lhr-solar/PS-Amperes/Hardware/docs/render.png

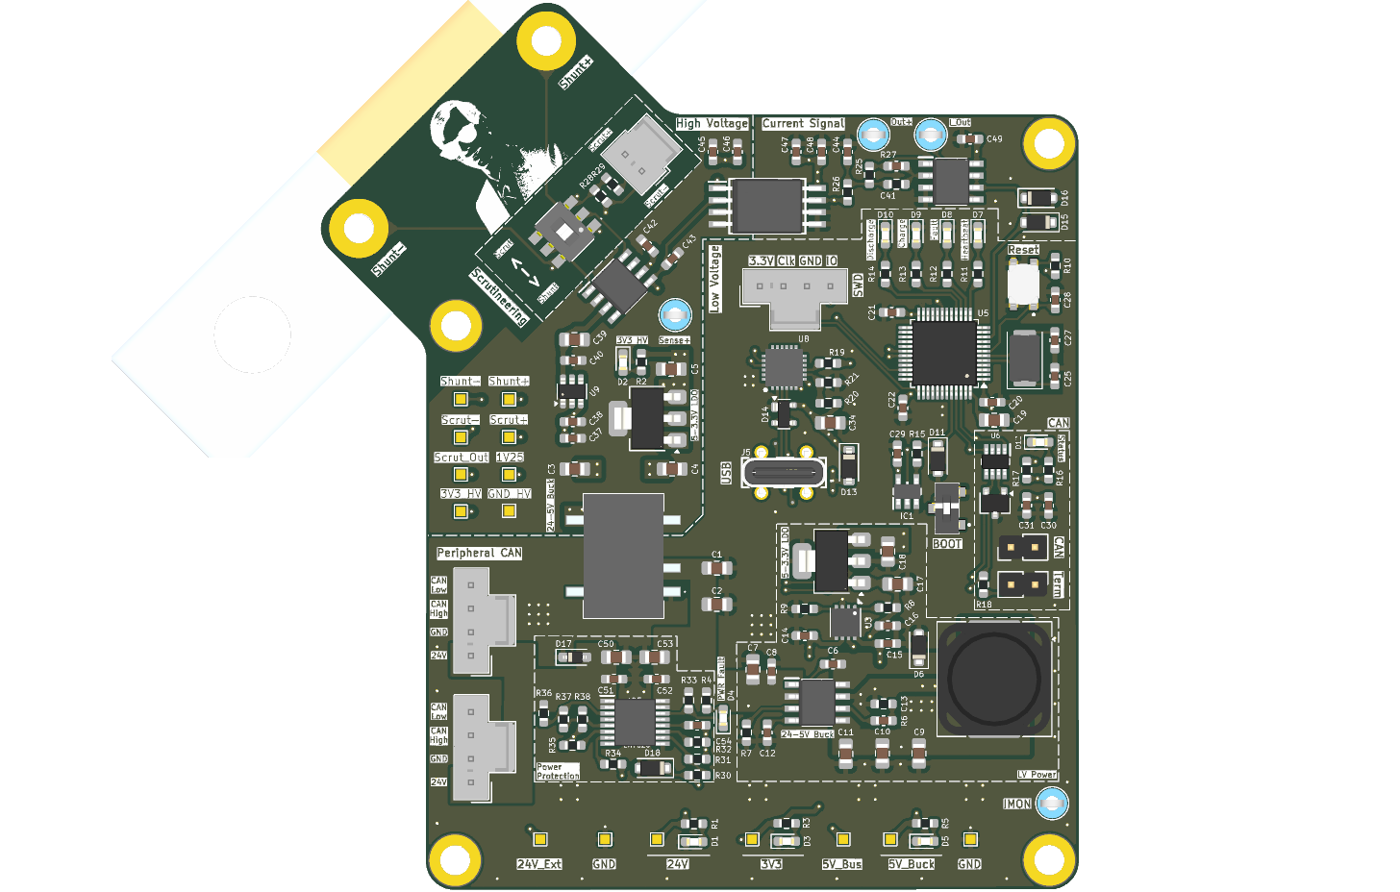
Hardware/docs/render.png
