lhr-solar/PS-Amperes/Hardware/Components/AMC1350DWVR/AMC1350DWVR.stp

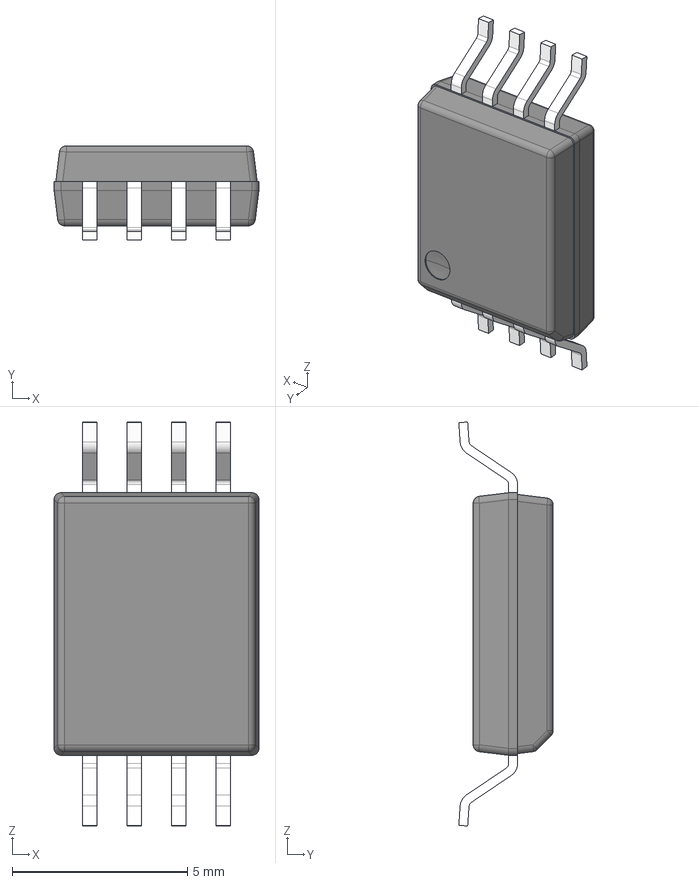
[picture p2: CAD file, 2025-11-04]
Hardware/Components/AMC1350DWVR/AMC1350DWVR.stp
5.85 x 2.70 x 11.5 mm
BODY-SOIC
LEAD-DWV0008A x 8
