lhr-solar/PS-Amperes/Hardware/Components/INA241A5IDR/INA241A5IDR.stp

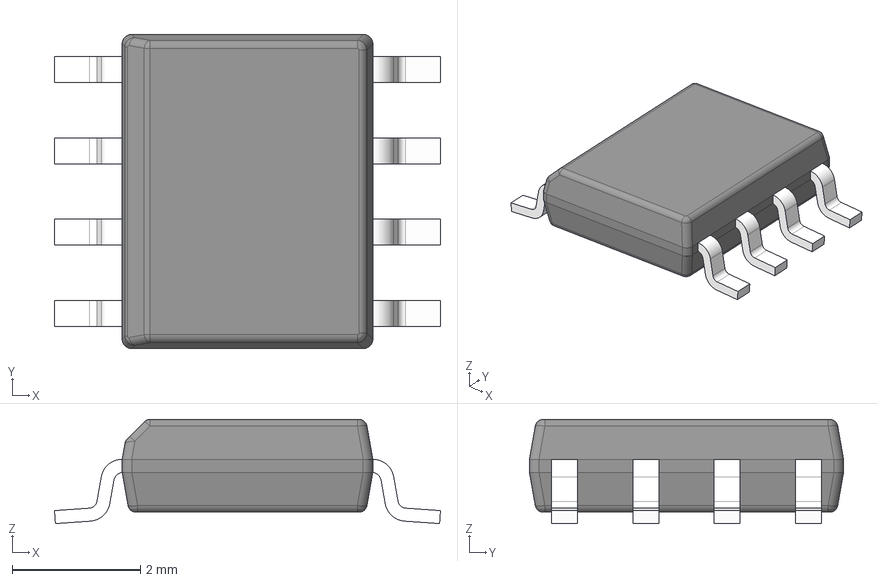
[picture p3: CAD file, 2025-11-04]
Hardware/Components/INA241A5IDR/INA241A5IDR.stp
6.02 x 4.90 x 1.63 mm
BODY-SO
LEAD-D0008A x 8
