lhr-solar/PS-Amperes/Hardware/Components/SN74AHC1G32DBVR/SN74AHC1G32DBVR.stp

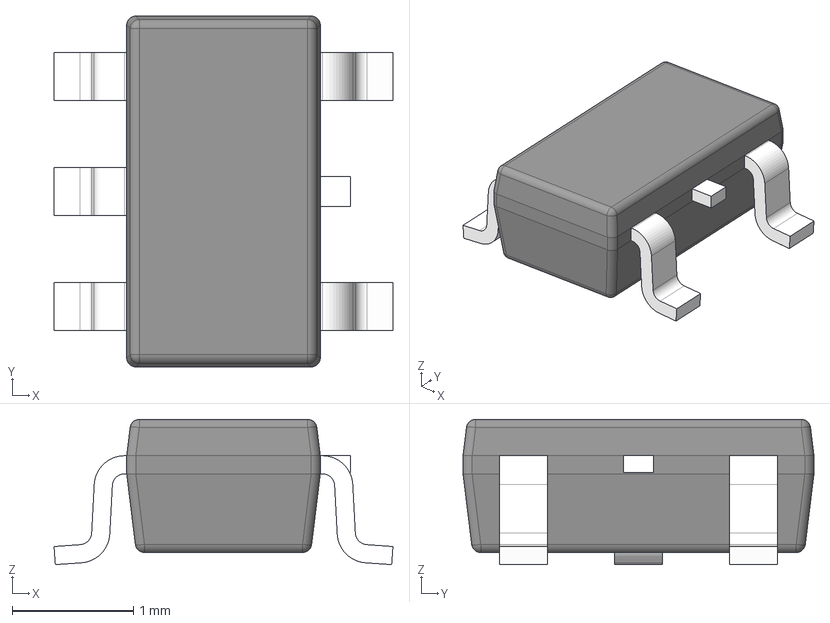
[picture p4: CAD file, 2025-11-04]
Hardware/Components/SN74AHC1G32DBVR/SN74AHC1G32DBVR.stp
2.80 x 2.90 x 1.20 mm
BODY-SOT
LEAD-SOT x 5
LEAD-DUMMY
