lhr-solar/PS-Amperes/Hardware/Components/TL3365AF180QG/TL3365AF180QG.step

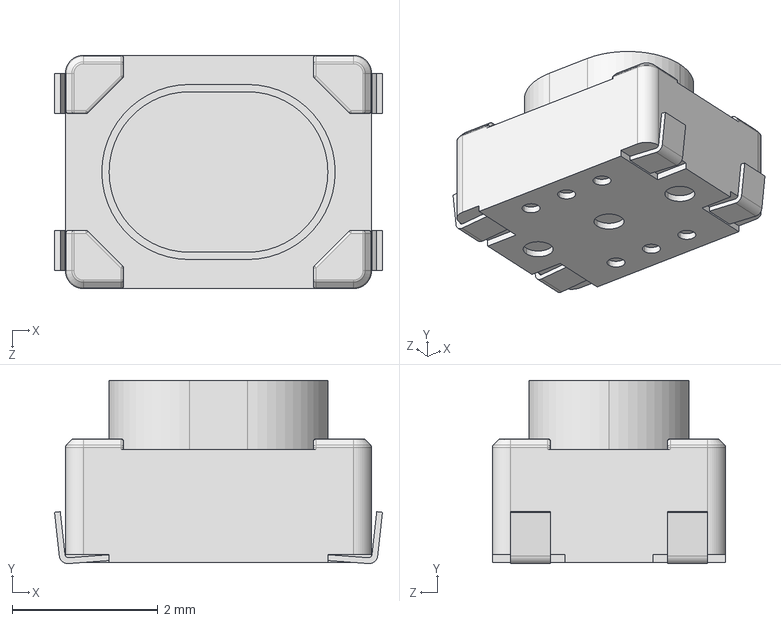
[picture p5: CAD file, 2025-11-04]
Hardware/Components/TL3365AF180QG/TL3365AF180QG.step
4.50 x 2.51 x 3.20 mm
