lhr-solar/PS-Amperes/Hardware/Components/TPS2115ADRBR/TPS2115ADRBR.step

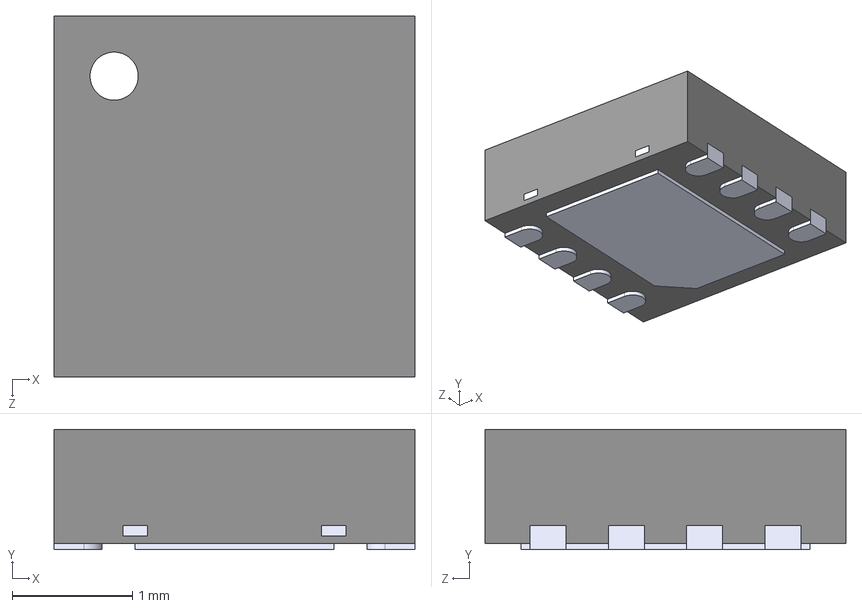
[picture p6: CAD file, 2025-11-04]
Hardware/Components/TPS2115ADRBR/TPS2115ADRBR.step
3.00 x 1.00 x 3.00 mm
