lhr-solar/PS-Amperes/Hardware/Components/USB4120-03-C/USB4120-03-C.stp

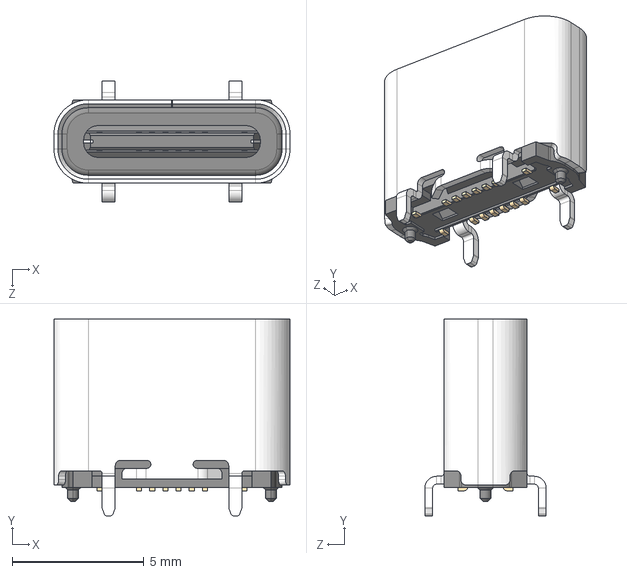
[picture p7: CAD file, 2025-11-04]
Hardware/Components/USB4120-03-C/USB4120-03-C.stp
8.94 x 7.45 x 4.60 mm
