lhr-solar/PS-Amperes/Hardware/Components/WSBS8518L2500JKM4/WSBS8518L2500JKM4.stp

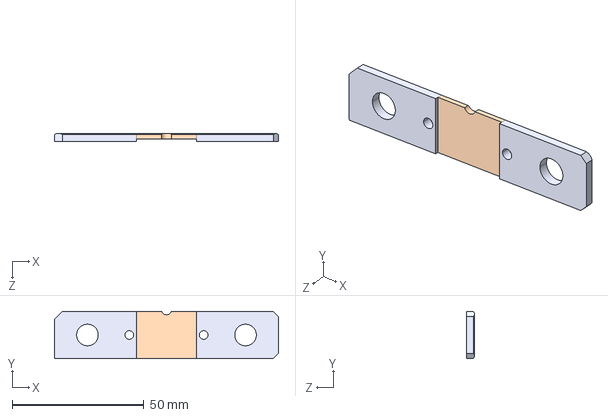
[picture p8: CAD file, 2025-11-04]
Hardware/Components/WSBS8518L2500JKM4/WSBS8518L2500JKM4.stp
85.0 x 18.0 x 3.00 mm
