lhr-solar/PS-Amperes/Hardware/Reference/amperesmax.DXF

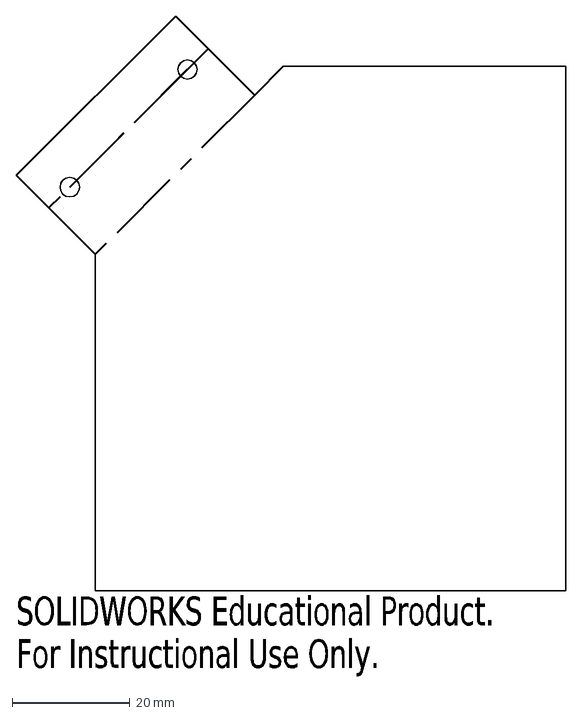
[picture p9: CAD file, 2025-11-04]
Hardware/Reference/amperesmax.DXF
SOLIDWORKS Educational Product.
For Instructional Use Only.
