lhr-solar/PS-Amperes/Hardware/docs/PS-AmperesPCB.pdf

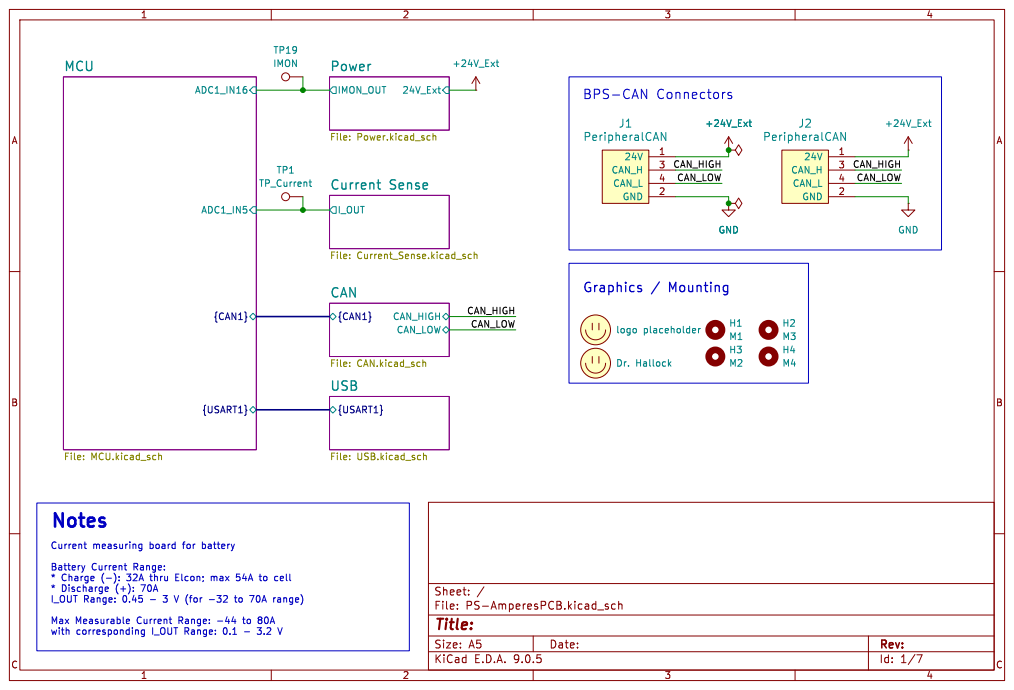
[picture p10: page 1]

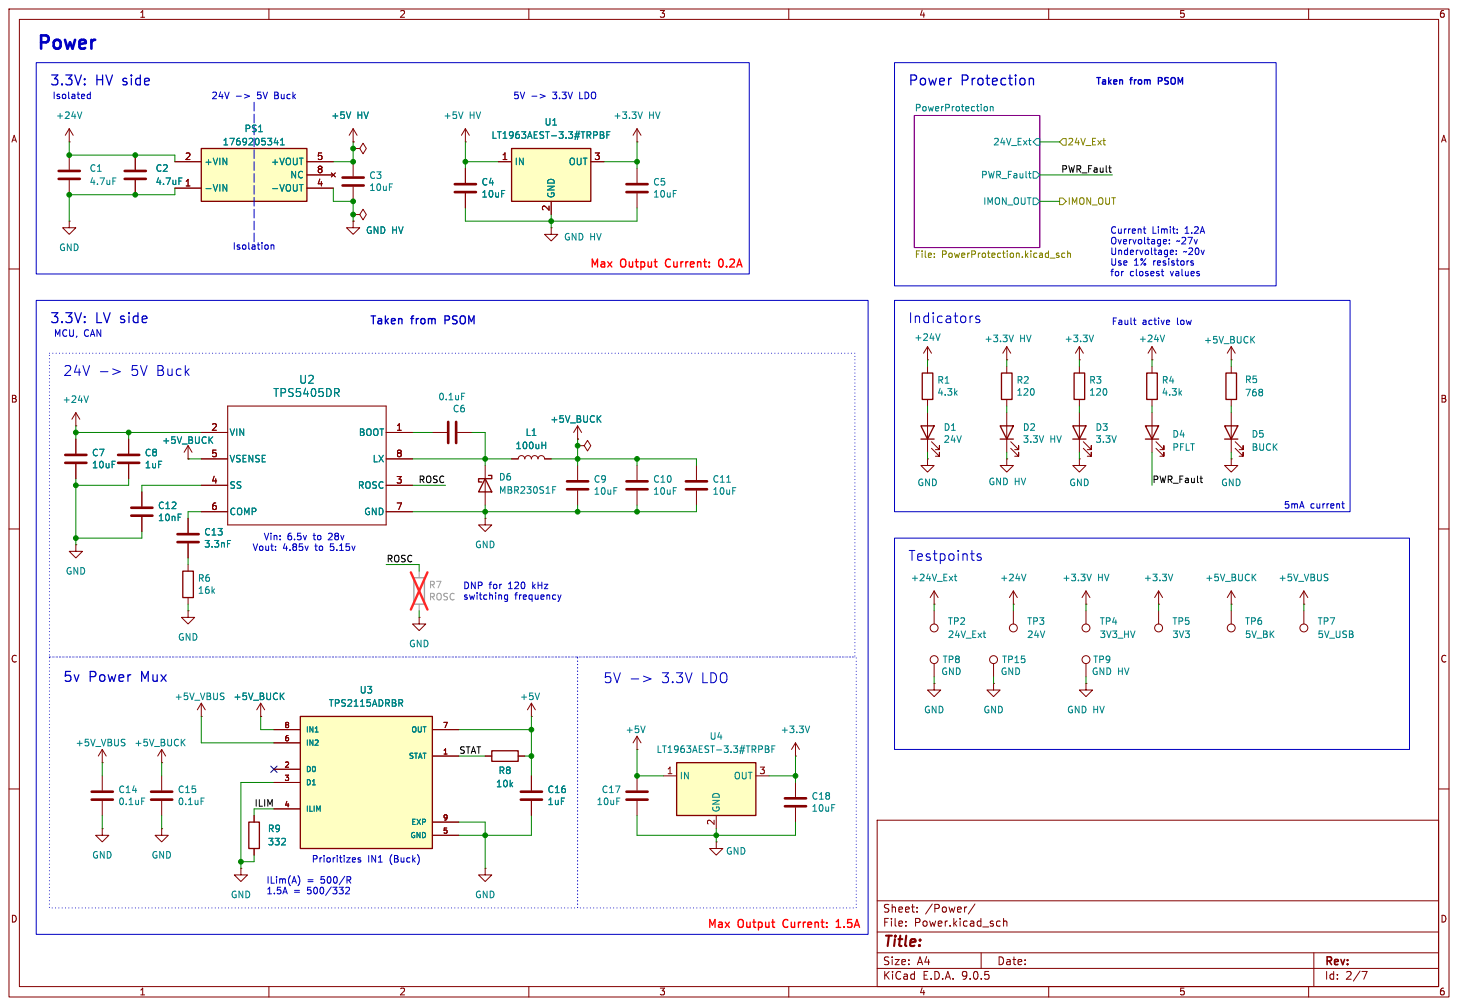
[picture p11: page 2]

Indicators Max Output Current: 0.2A

Vin: 6.5v to 28v Vout: 4.85v to 5.15v 5v Power Mux

Id: 2/7 Title: File: Power.kicad_sch Sheet: /Power/

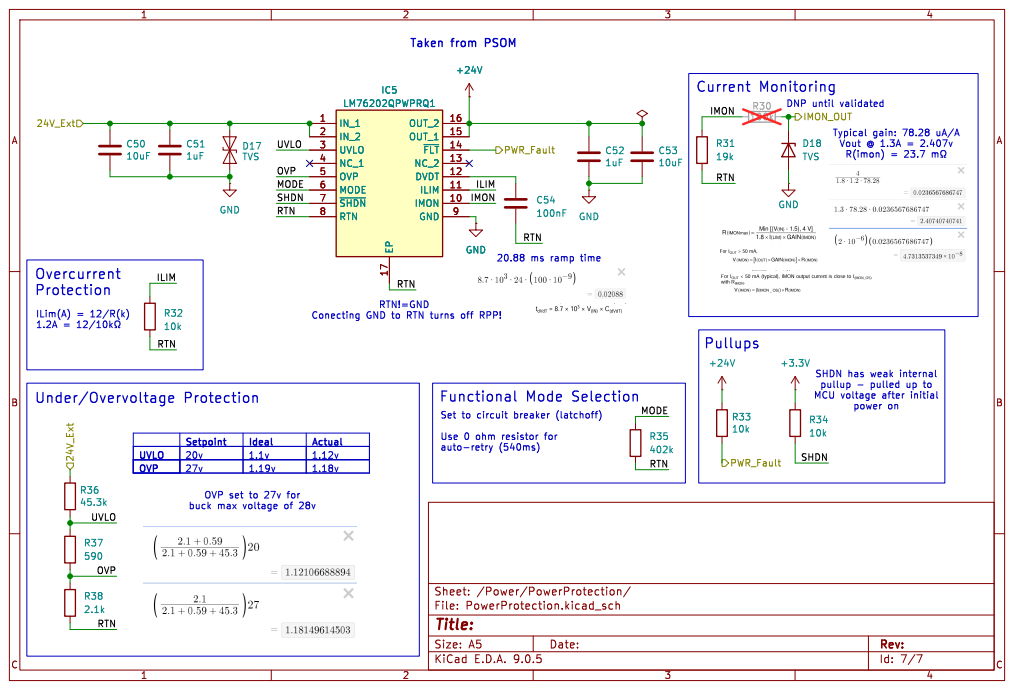
[picture p12: page 3]

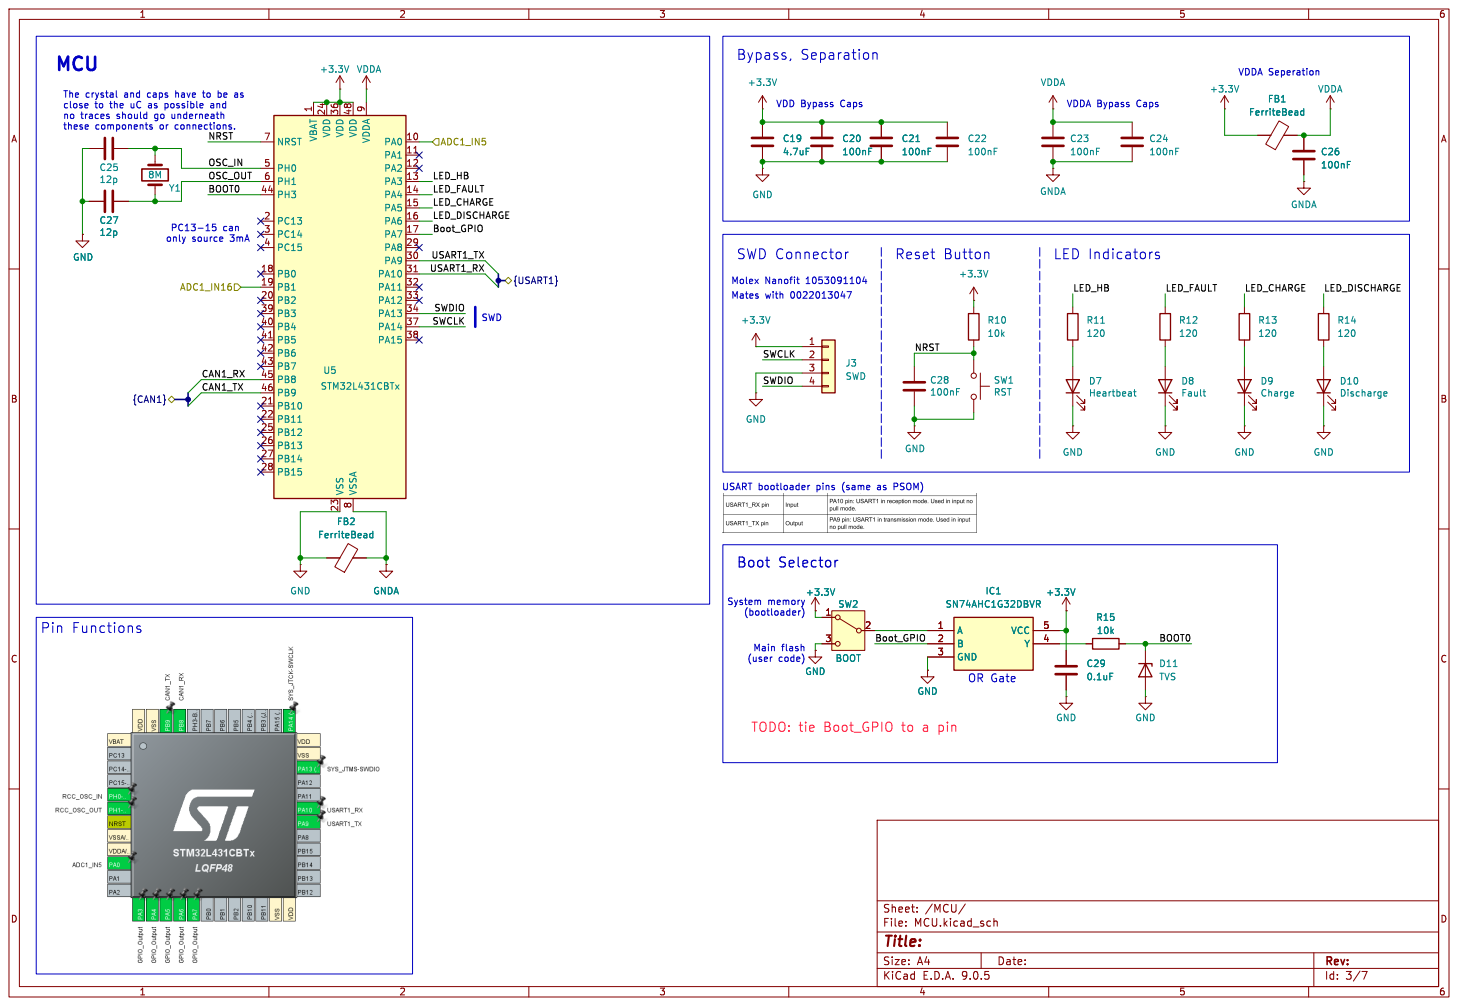
[picture p13: page 4]

+3.3V GND
The crystal and caps have to be as
no traces should go underneath

1 VDD 24 VDD 36 VSS 23 VDD 48 VSSA

TODO: tie Boot_GPIO to a pin Main flash

Id: 3/7 Title: File: MCU.kicad_sch Sheet: /MCU/

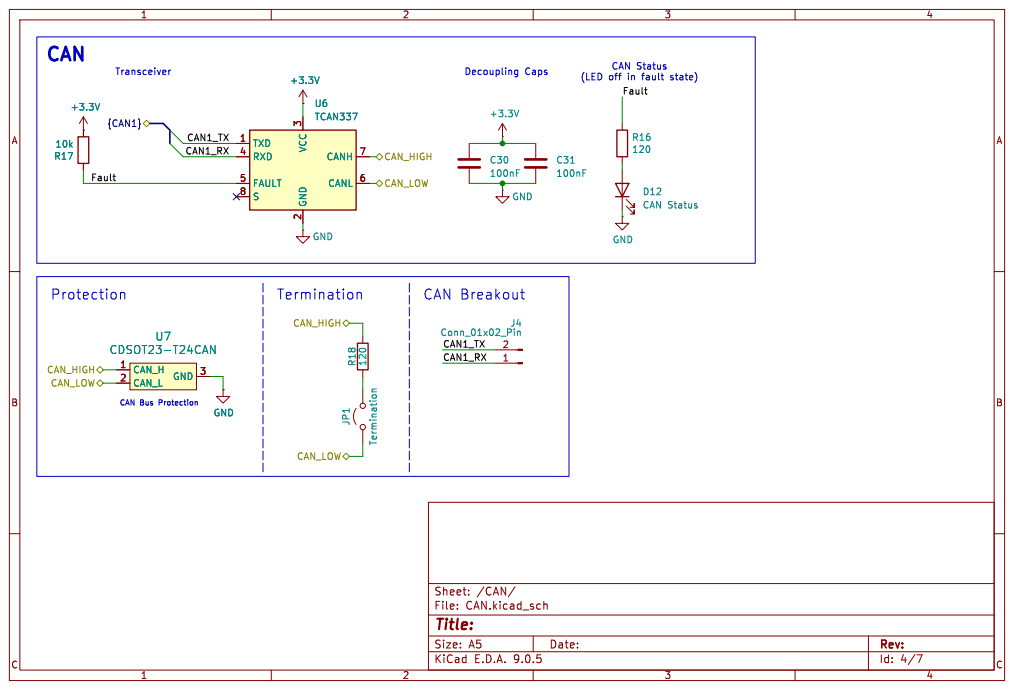
[picture p14: page 5]

(LED off in fault state)

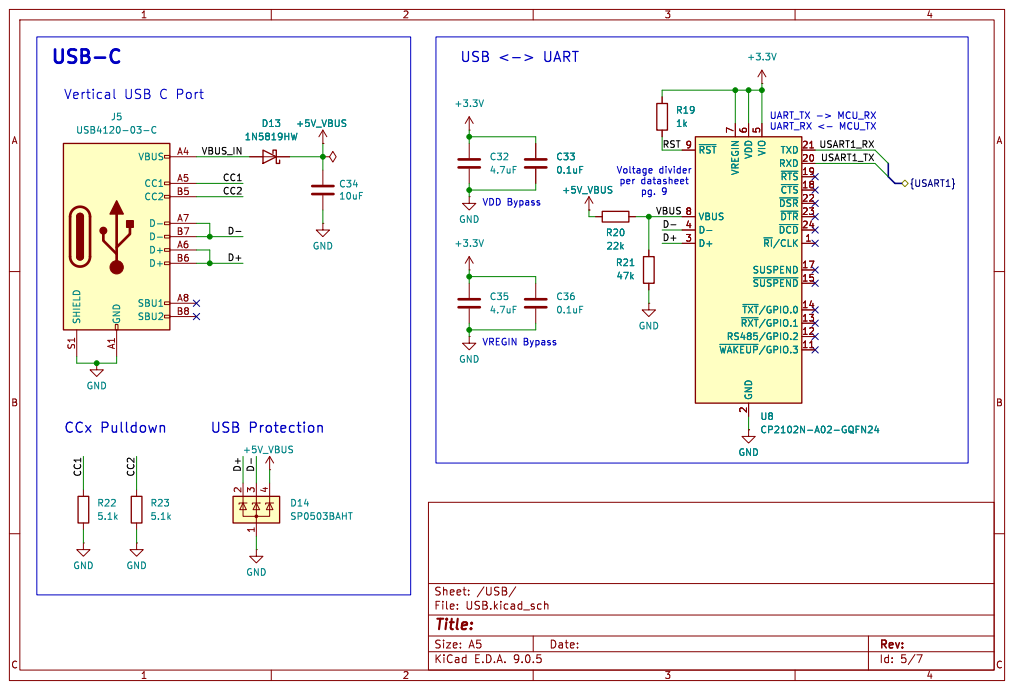
[picture p15: page 6]

5 TXD 21 RXD 20 ~{RTS} 19 ~{CTS} 18 ~{DSR} 22 ~{DTR} 23 ~{DCD} 24 ~{RI}/CLK1 SUSPEND 17 ~{SUSPEND}15 ~{TXT}/GPIO.014 ~{RXT}/GPIO.113 RS485/GPIO.2 12 ~{WAKEUP}/GPIO.311 U8 CP2102N-A02-GQFN24 R21

5 TXD 21 RXD 20 ~{RTS} 19 ~{CTS} 18 ~{DSR} 22 ~{DTR} 23 ~{DCD} 24 ~{RI}/CLK1 SUSPEND 17 ~{SUSPEND}15 ~{TXT}/GPIO.014 ~{RXT}/GPIO.113 RS485/GPIO.2 12 ~{WAKEUP}/GPIO.311 R21

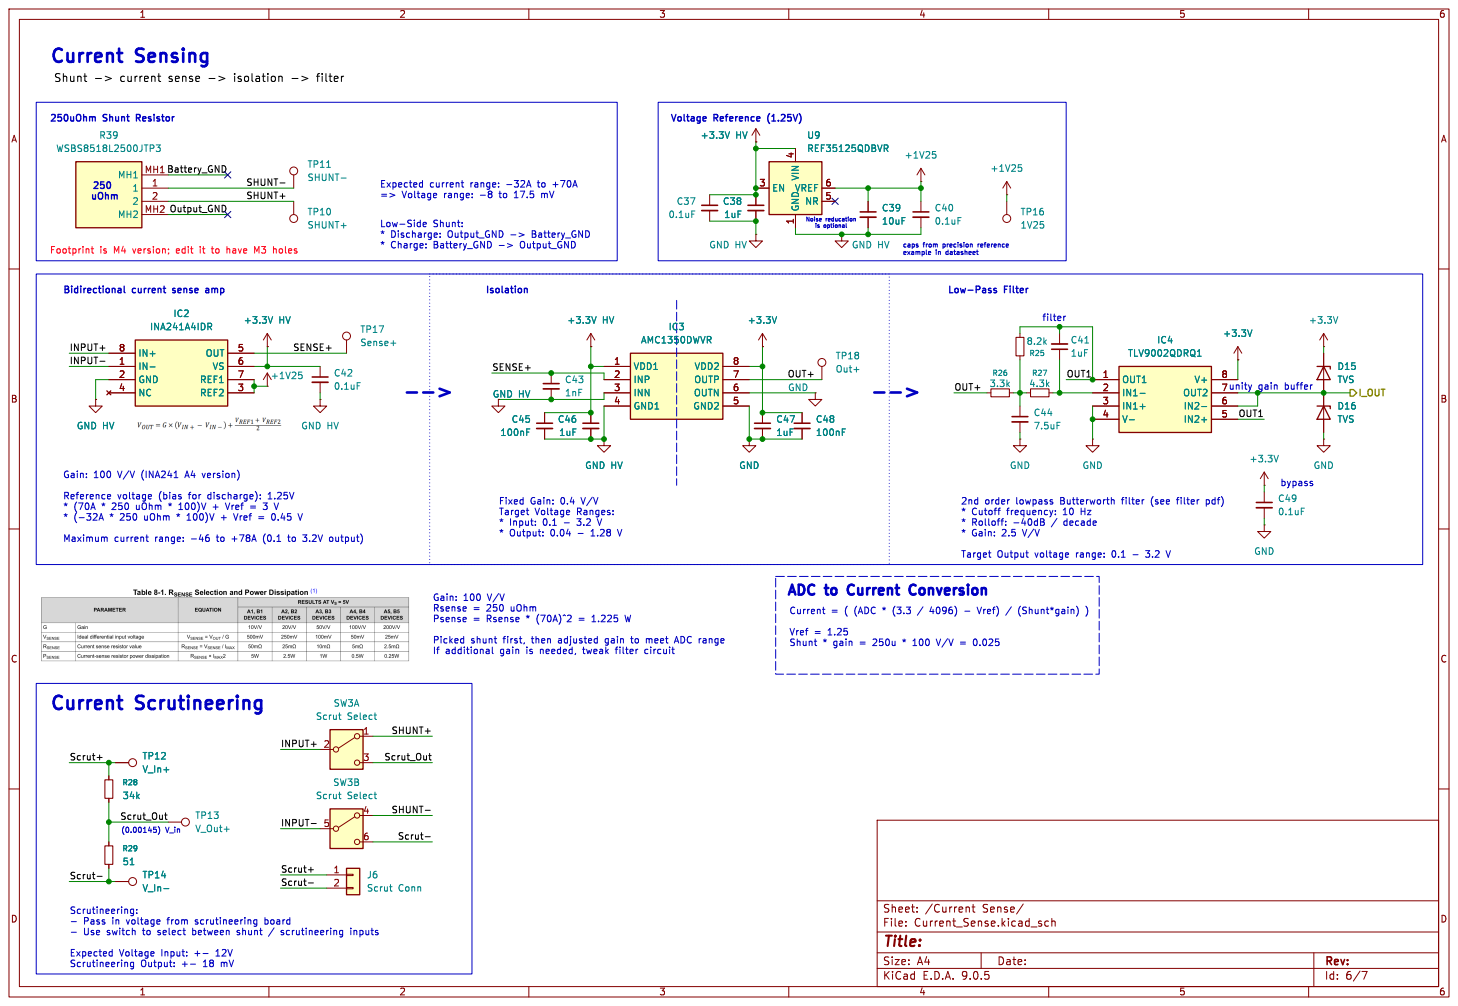
[picture p16: page 7]

Voltage Reference (1.25V) Noise reducation

=> Voltage range: -8 to 17.5 mV

is optional Fixed Gain: 0.4 V/V

Scrut Select GND HV

Target Voltage Ranges: * Input: 0.1 - 3.2 V

Target Output voltage range: 0.1 - 3.2 V
