lhr-solar/PS-Amperes/Hardware/docs/layoutFront/PS-AmperesPCB.pdf

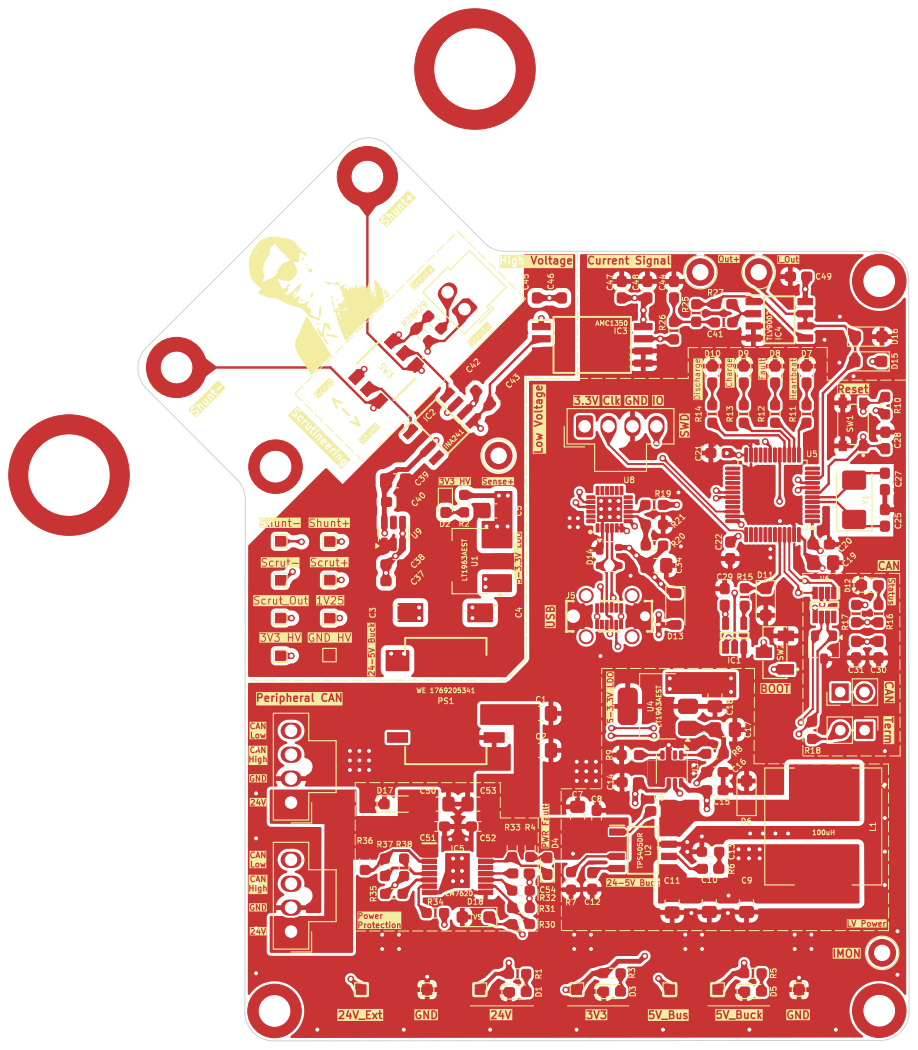
[picture p17: page 1]

Id: 1/1 Title: File: PS-AmperesPCB.kicad_pcb Sheet: INA241 <->
