lhr-solar/PS-Amperes/Hardware/docs/layoutBack/PS-AmperesPCB.pdf

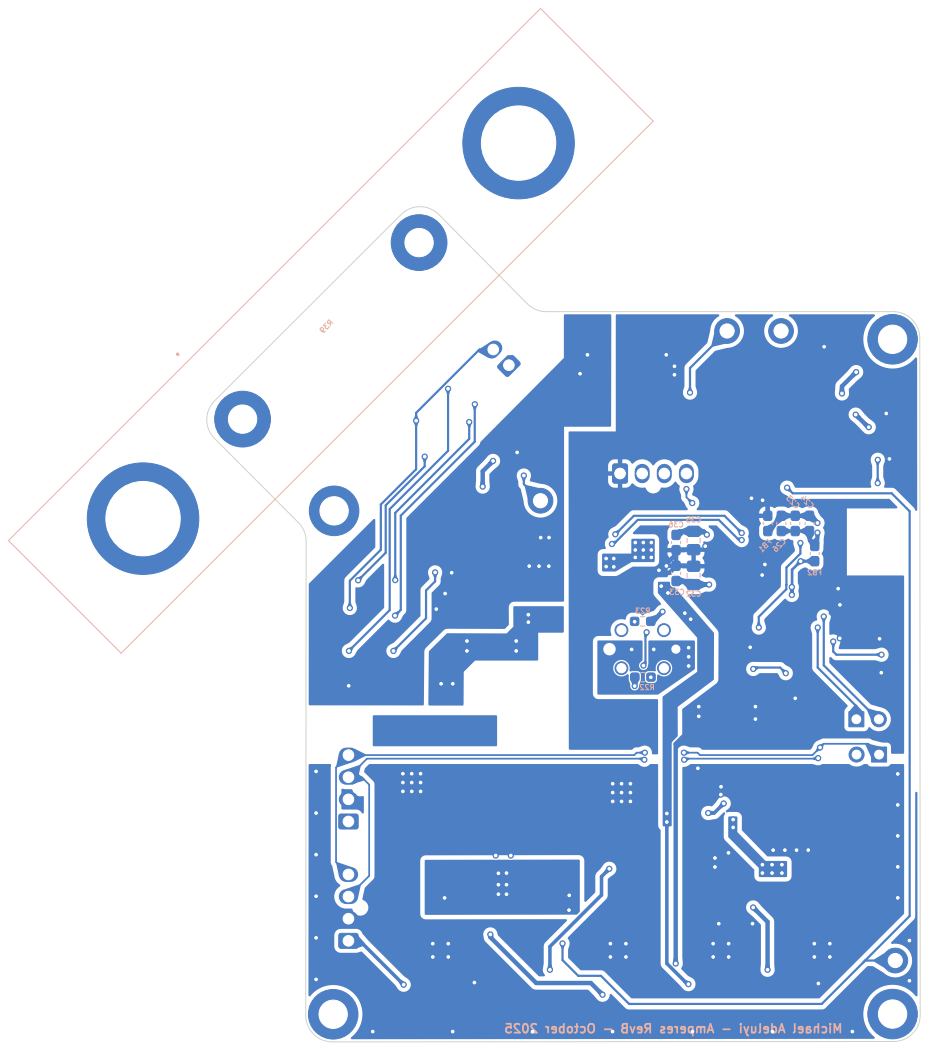
[picture p18: page 1]
