lhr-solar/PS-Amperes/Hardware/PS-AmperesPCB.kicad_pcb

## KiCad design Hardware/PS-AmperesPCB.kicad_pcb (2025-11-04)

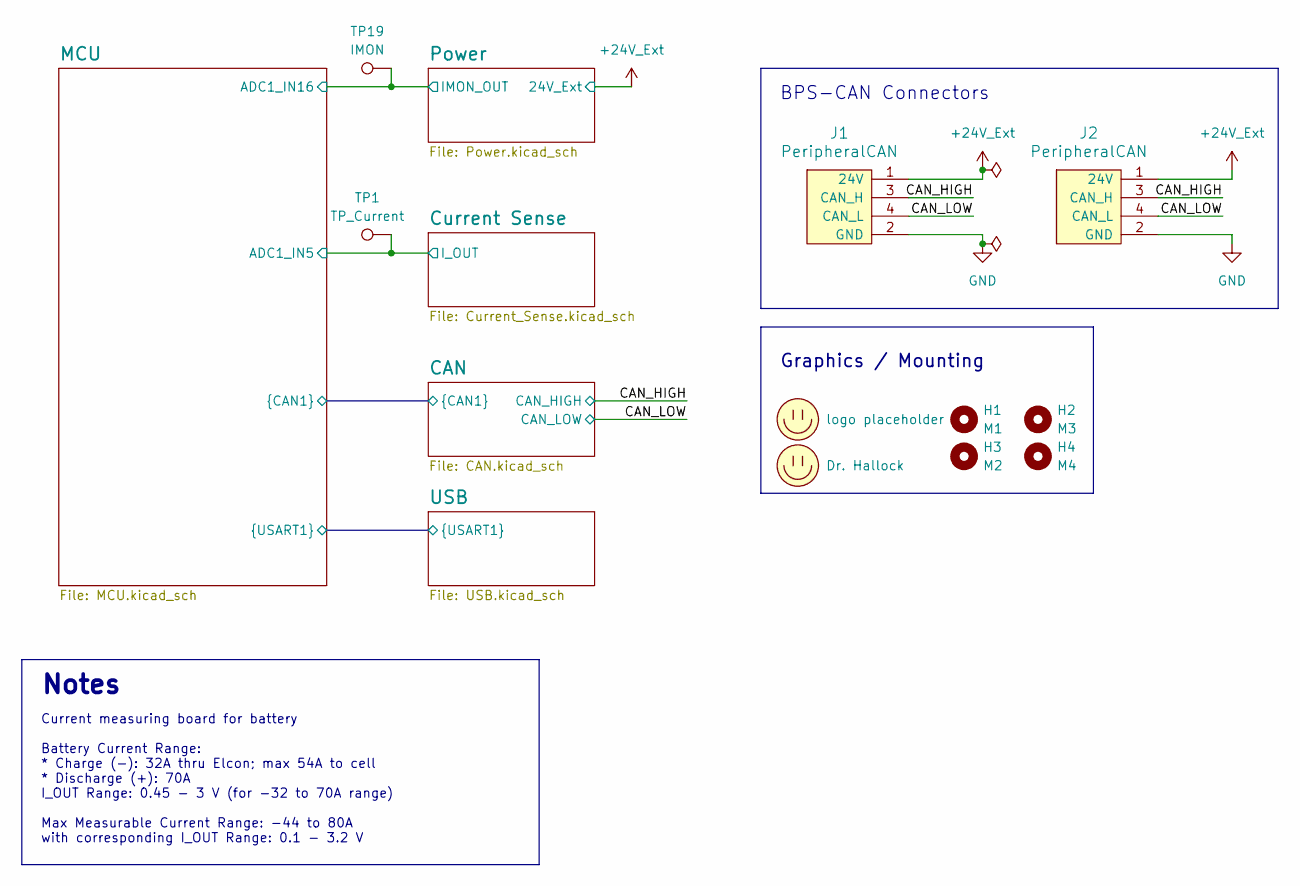
[picture p19: schematic PS-AmperesPCB.kicad_sch]

Parts:
H1: M1; MountingHole_3.2mm_M3_DIN965_Pad_TopBottom
H2: M3; MountingHole_3.2mm_M3_DIN965_Pad_TopBottom
H3: M2; MountingHole_3.2mm_M3_DIN965_Pad_TopBottom
H4: M4; MountingHole_3.2mm_M3_DIN965_Pad_TopBottom
J1, J2: PeripheralCAN; Molex_Nano-Fit_105309-xx04_1x04_P2.50mm_Vertical
LOGO1: logo placeholder; LHRs_LOGO
LOGO2: Dr. Hallock; Hallock_Image_Tiny
TP1: TP_Current; TestPoint_Keystone_5005-5009_Compact
TP19: IMON; TestPoint_Keystone_5005-5009_Compact

Connections:
+24V_Ext: J1.1 (24V), J2.1 (24V); also elsewhere on the board
/CAN_HIGH: J1.3 (CAN_H), J2.3 (CAN_H); also elsewhere on the board
/CAN_LOW: J1.4 (CAN_L), J2.4 (CAN_L); also elsewhere on the board
/Current Sense/I_OUT: TP1.1; also elsewhere on the board
/MCU/ADC1_IN16: TP19.1; also elsewhere on the board
GND: J1.2 (GND), J2.2 (GND); also elsewhere on the board

Notes on the sheet:
Notes
Graphics / Mounting
Current measuring board for battery Battery Current Range: * Charge (-): 32A thru Elcon; max 54A to cell * Discharge (+): 70A I_OUT Range: 0.45 - 3 V (for -32 to 70A range) Max Measurable Current Range: -44 to 80A with corresponding I_OUT Range: 0.1 - 3.2 V
BPS-CAN Connectors

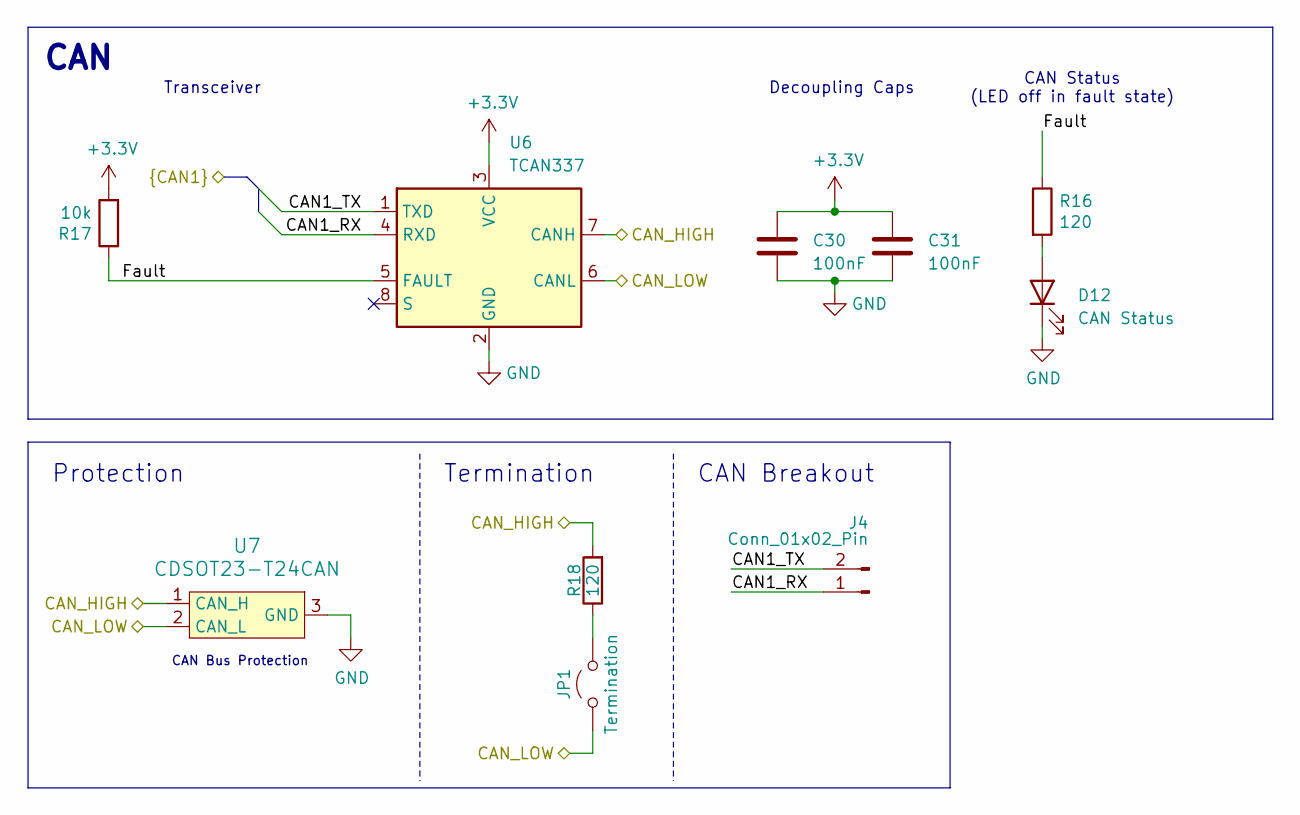
[picture p20: schematic CAN.kicad_sch]

Parts:
C30, C31: 100nF; C_0603_1608Metric_Pad1.08x0.95mm_HandSolder; Mouser Part Number 80-C0805C104M5R
D12: CAN Status; LED_0603_1608Metric_Pad1.05x0.95mm_HandSolder
J4: Conn_01x02_Pin; PinHeader_1x02_P2.54mm_Vertical
JP1: Termination; PinHeader_1x02_P2.54mm_Vertical
R16: 120; R_0603_1608Metric_Pad0.98x0.95mm_HandSolder; Mouser Part Number Inventory
R17: 10k; R_0603_1608Metric_Pad0.98x0.95mm_HandSolder
R18: 120; R_0603_1608Metric_Pad0.98x0.95mm_HandSolder; Mouser Part Number 71-CRCW080559R0FKEA
U6: TCAN337; TCAN337DCNR
U7: CDSOT23-T24CAN

Connections:
+3.3V: C30.1, C31.1, R17.2, U6.3 (VCC); also elsewhere on the board
/CAN/CAN1_RX: J4.1, U6.4 (RXD); also elsewhere on the board
/CAN/CAN1_TX: J4.2, U6.1 (TXD); also elsewhere on the board
/CAN/Fault: R16.1, R17.1, U6.5 (FAULT)
/CAN_HIGH: R18.2, U6.7 (CANH), U7.1 (CAN_H); also elsewhere on the board
/CAN_LOW: JP1.1 (A), U6.6 (CANL), U7.2 (CAN_L); also elsewhere on the board
GND: C30.2, C31.2, D12.1 (K), U6.2 (GND), U7.3 (GND); also elsewhere on the board
unnamed: D12.2 (A), R16.2
unnamed: JP1.2 (B), R18.1

Notes on the sheet:
Transceiver
CAN Breakout
Decoupling Caps
Protection
CAN Status (LED off in fault state)
Termination
CAN
CAN Bus Protection

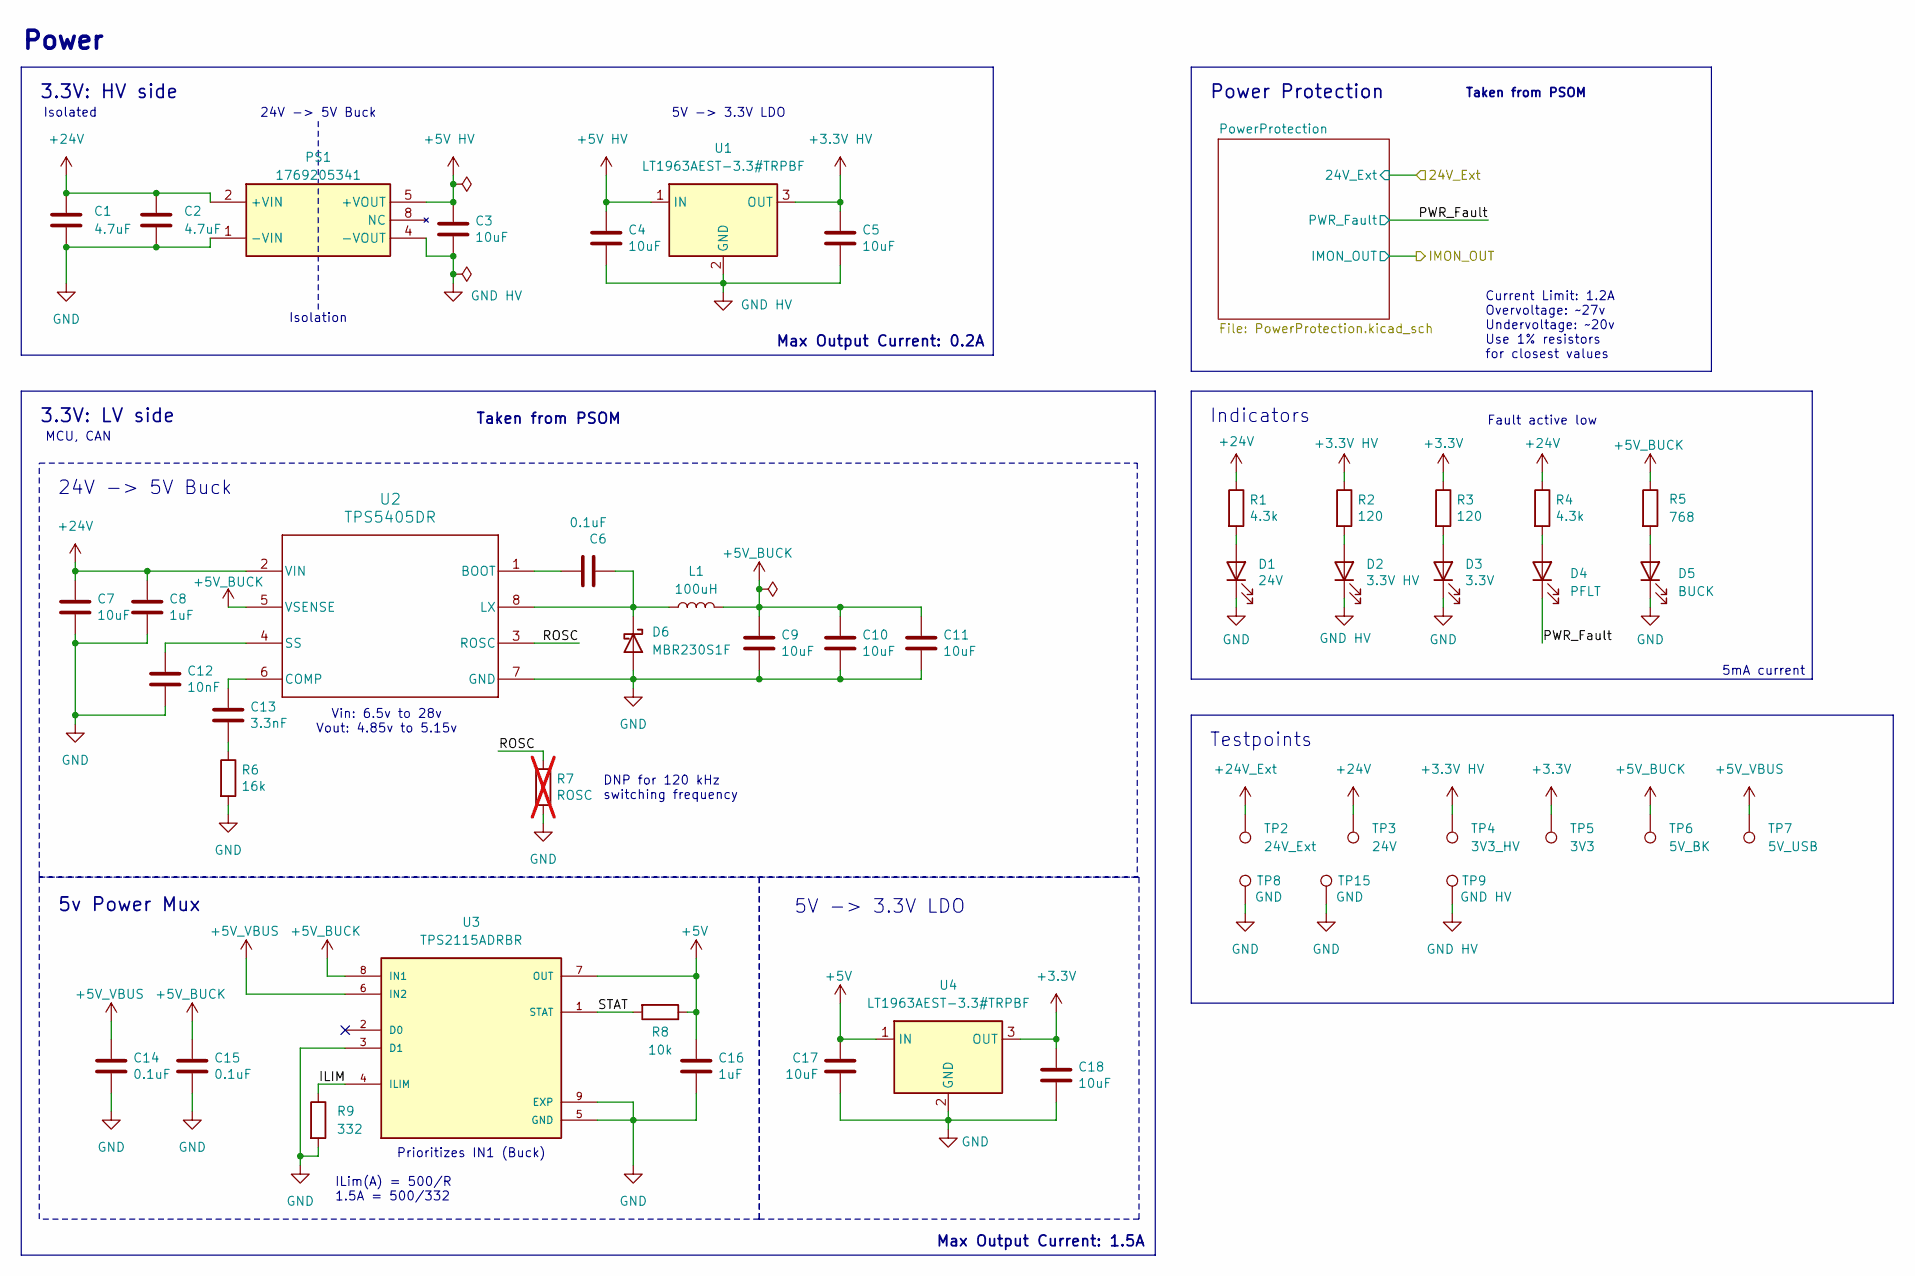
[picture p21: schematic Power.kicad_sch]

Parts:
C1, C2: 4.7uF; C_0805_2012Metric_Pad1.18x1.45mm_HandSolder
C3, C4, C5, C7, C9, C10, C11, C17, C18: 10uF; C_0805_2012Metric_Pad1.18x1.45mm_HandSolder
C6, C14, C15: 0.1uF; C_0603_1608Metric_Pad1.08x0.95mm_HandSolder
C8, C16: 1uF; C_0603_1608Metric_Pad1.08x0.95mm_HandSolder
C12: 10nF; C_0603_1608Metric_Pad1.08x0.95mm_HandSolder
C13: 3.3nF; C_0603_1608Metric_Pad1.08x0.95mm_HandSolder
D1: 24V; LED_0603_1608Metric_Pad1.05x0.95mm_HandSolder
D2: 3.3V HV; LED_0603_1608Metric_Pad1.05x0.95mm_HandSolder
D3: 3.3V; LED_0603_1608Metric_Pad1.05x0.95mm_HandSolder
D4: PFLT; LED_0603_1608Metric_Pad1.05x0.95mm_HandSolder
D5: BUCK; LED_0603_1608Metric_Pad1.05x0.95mm_HandSolder
D6: MBR230S1F; D_SOD-123F
L1: 100uH; L_Coilcraft_MSS1246-XXX
PS1: 1769205341; WE_1769205341; Mouser Part Number 710-1769205341
R1, R4: 4.3k; R_0603_1608Metric_Pad0.98x0.95mm_HandSolder
R2, R3: 120; R_0603_1608Metric_Pad0.98x0.95mm_HandSolder
R5: 768; R_0603_1608Metric_Pad0.98x0.95mm_HandSolder
R6: 16k; R_0603_1608Metric_Pad0.98x0.95mm_HandSolder
R7: ROSC; R_0603_1608Metric_Pad0.98x0.95mm_HandSolder; not fitted
R8: 10k; R_0603_1608Metric_Pad0.98x0.95mm_HandSolder
R9: 332; R_0603_1608Metric_Pad0.98x0.95mm_HandSolder
TP2: 24V_Ext; TestPoint_Pad_1.0x1.0mm
TP3: 24V; TestPoint_Pad_1.0x1.0mm
TP4: 3V3_HV; TestPoint_Pad_1.0x1.0mm
TP5: 3V3; TestPoint_Pad_1.0x1.0mm
TP6: 5V_BK; TestPoint_Pad_1.0x1.0mm
TP7: 5V_USB; TestPoint_Pad_1.0x1.0mm
TP8, TP15: GND; TestPoint_Pad_1.0x1.0mm
TP9: GND HV; TestPoint_Pad_1.0x1.0mm
U1, U4: LT1963AEST-3.3#TRPBF; SOT-223-3_TabPin2
U2: TPS5405DR
U3: TPS2115ADRBR; VSON-8-1EP_3x3mm_P0.65mm_EP1.65x2.4mm

Connections:
+3.3V: C18.1, R3.1, TP5.1, U4.3 (OUT); also elsewhere on the board
+3.3V HV: C5.1, R2.1, TP4.1, U1.3 (OUT); also elsewhere on the board
+5V: C16.1, C17.1, R8.1, U3.7 (OUT), U4.1 (IN)
+5V HV: C3.1, C4.1, PS1.5 (+VOUT), U1.1 (IN)
+5V_BUCK: C9.1, C10.1, C11.1, C15.1, L1.2, R5.1, TP6.1, U2.5 (VSENSE), U3.8 (IN1)
+5V_VBUS: C14.1, TP7.1, U3.6 (IN2); also elsewhere on the board
+24V: C1.1, C2.1, C7.1, C8.1, PS1.2 (+VIN), R1.1, R4.1, TP3.1, U2.2 (VIN); also elsewhere on the board
+24V_Ext: TP2.1; also elsewhere on the board
/Power/ILIM: R9.1, U3.4 (ILIM)
/Power/PWR_Fault: D4.1 (K); also elsewhere on the board
/Power/ROSC: R7.1, U2.3 (ROSC)
/Power/STAT: R8.2, U3.1 (STAT)
GND: C1.2, C2.2, C7.2, C8.2, C9.2, C10.2, C11.2, C12.2, C14.2, C15.2, C16.2, C17.2, C18.2, D1.1 (K), D3.1 (K), D5.1 (K), D6.2 (A), PS1.1 (-VIN), R6.2, R7.2, R9.2, TP8.1, TP15.1, U2.7 (GND), U3.3 (D1), U3.5 (GND), U3.9 (EXP), U4.2 (GND); also elsewhere on the board
GND HV: C3.2, C4.2, C5.2, D2.1 (K), PS1.4 (-VOUT), TP9.1, U1.2 (GND); also elsewhere on the board
unnamed: C13.2, R6.1
unnamed: D1.2 (A), R1.2
unnamed: D2.2 (A), R2.2
unnamed: D3.2 (A), R3.2
unnamed: D4.2 (A), R4.2
unnamed: D5.2 (A), R5.2
unnamed: C6.2, D6.1 (K), L1.1, U2.8 (LX)
unnamed: C6.1, U2.1 (BOOT)
unnamed: C13.1, U2.6 (COMP)
unnamed: C12.1, U2.4 (SS)

Notes on the sheet:
Isolation
Max Output Current: 1.5A
Power
Testpoints
Isolated
Taken from PSOM
Indicators
Max Output Current: 0.2A
3.3V: HV side
Prioritizes IN1 (Buck)
5v Power Mux
24V -> 5V Buck
5V -> 3.3V LDO
Current Limit: 1.2A Overvoltage: ~27v Undervoltage: ~20v Use 1% resistors for closest values
DNP for 120 kHz switching frequency
ILim(A) = 500/R 1.5A = 500/332
Vin: 6.5v to 28v Vout: 4.85v to 5.15v
5mA current
MCU, CAN
3.3V: LV side
Power Protection
Fault active low

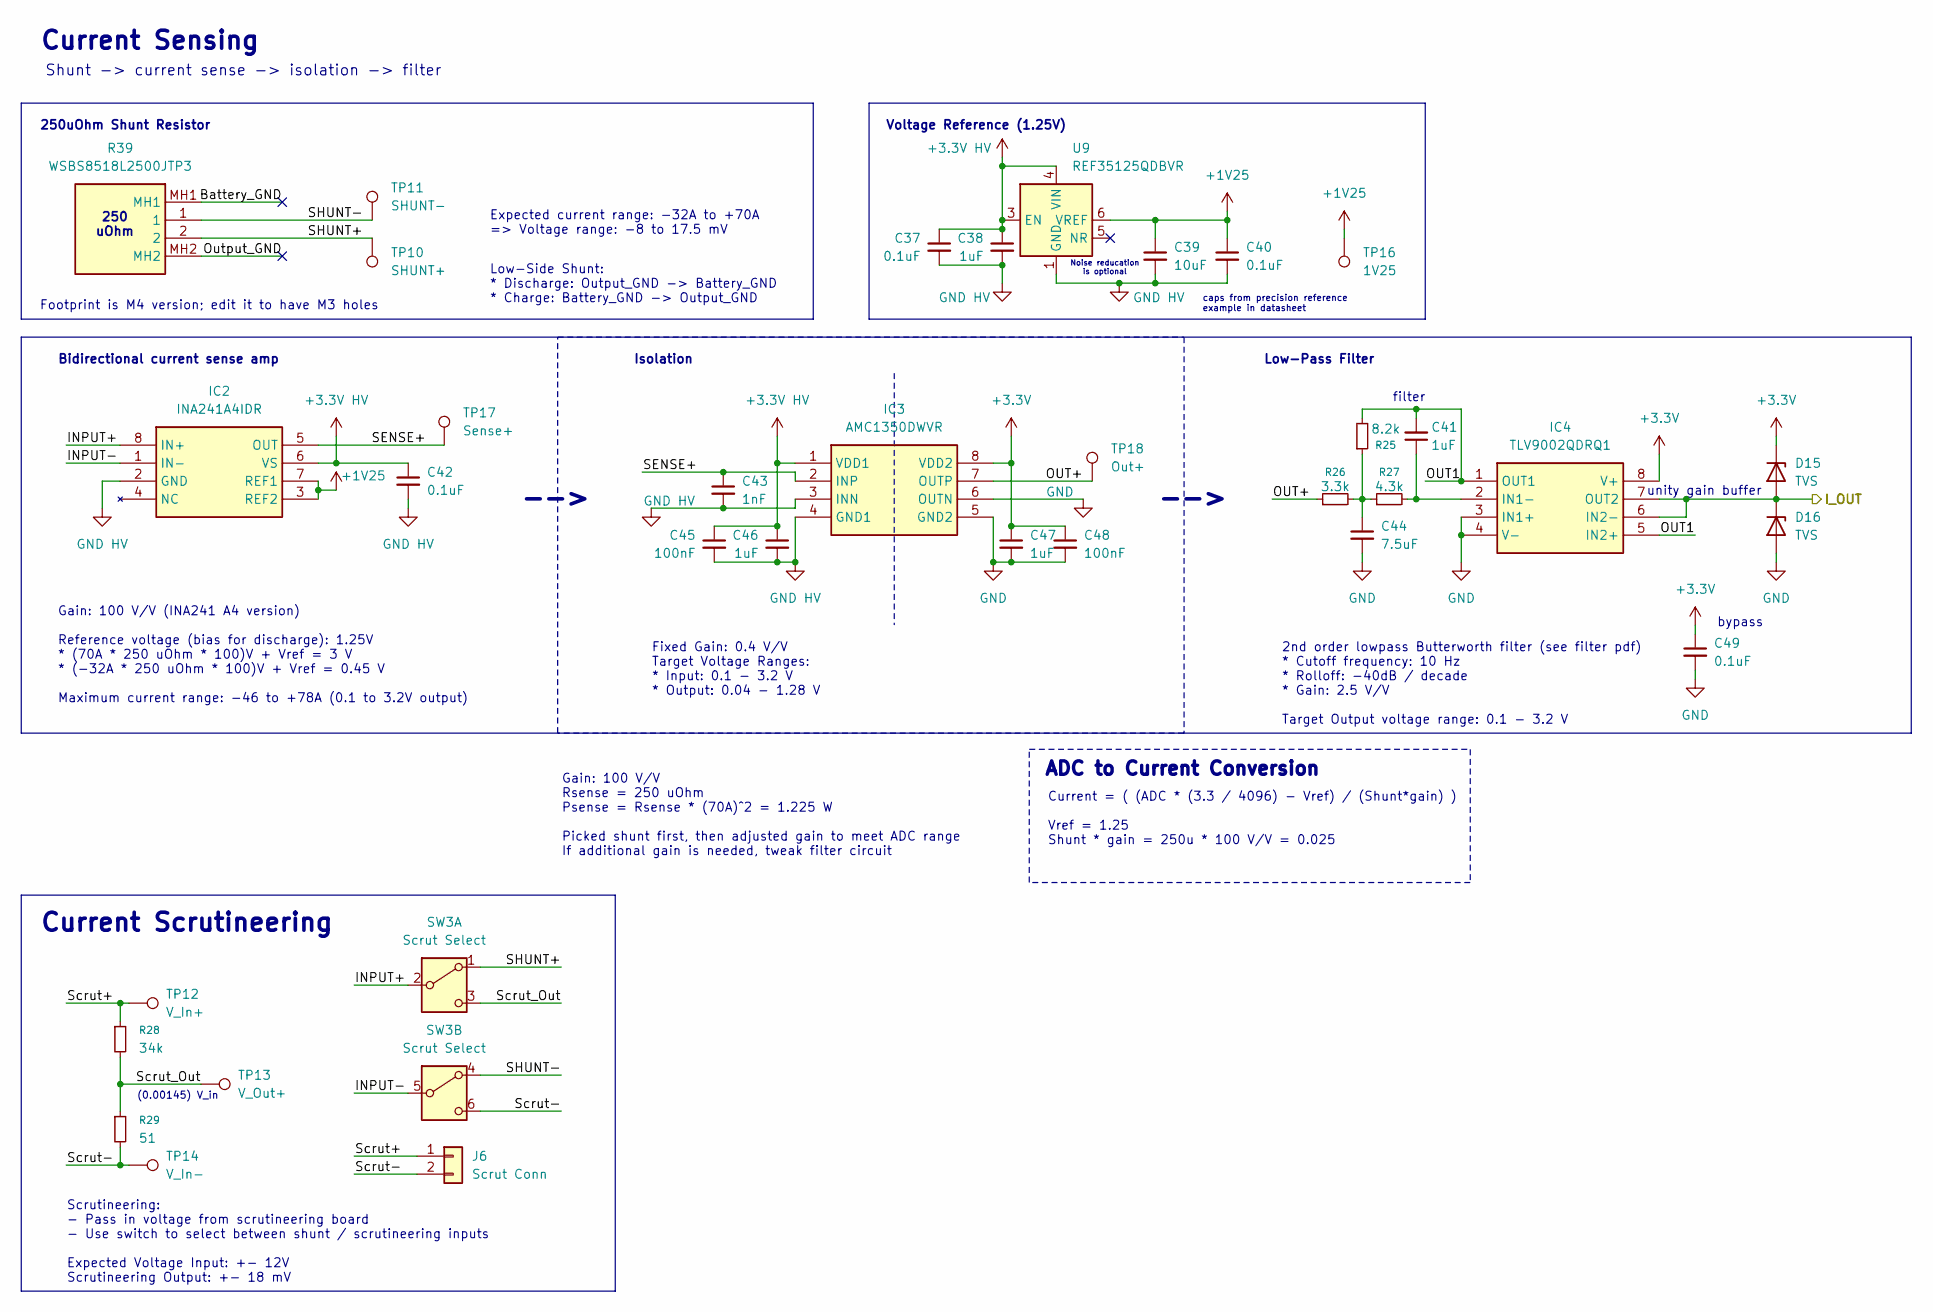
[picture p22: schematic Current_Sense.kicad_sch]

Parts:
C37, C40, C42, C49: 0.1uF; C_0603_1608Metric_Pad1.08x0.95mm_HandSolder
C38, C41, C46, C47: 1uF; C_0603_1608Metric_Pad1.08x0.95mm_HandSolder
C39: 10uF; C_0805_2012Metric_Pad1.18x1.45mm_HandSolder
C43: 1nF; C_0603_1608Metric_Pad1.08x0.95mm_HandSolder
C44: 7.5uF; C_0603_1608Metric_Pad1.08x0.95mm_HandSolder
C45, C48: 100nF; C_0603_1608Metric_Pad1.08x0.95mm_HandSolder
D15, D16: TVS; D_SOD-123F; Mouser Part Number 576-SMF3.3
IC2: INA241A4IDR; INA241A5IDR; Mouser Part Number 595-INA241A4IDR
IC3: AMC1350DWVR; Mouser Part Number 595-AMC1350DWVR
IC4: TLV9002QDRQ1; Mouser Part Number 595-TLV9002QDRQ1
J6: Scrut Conn; Molex_Nano-Fit_105309-xx02_1x02_P2.50mm_Vertical
R25: 8.2k; R_0603_1608Metric_Pad0.98x0.95mm_HandSolder
R26: 3.3k; R_0603_1608Metric_Pad0.98x0.95mm_HandSolder
R27: 4.3k; R_0603_1608Metric_Pad0.98x0.95mm_HandSolder
R28: 34k; R_0603_1608Metric_Pad0.98x0.95mm_HandSolder
R29: 51; R_0603_1608Metric_Pad0.98x0.95mm_HandSolder
R39: WSBS8518L2500JTP3; WSBS8518L2500JKM4; Mouser Part Number 71-WSBS8518L2500JTP3
SW3: Scrut Select; CAS220TB
TP10: SHUNT+; TestPoint_Pad_1.0x1.0mm
TP11: SHUNT-; TestPoint_Pad_1.0x1.0mm
TP12: V_In+; TestPoint_Pad_1.0x1.0mm
TP13: V_Out+; TestPoint_Pad_1.0x1.0mm
TP14: V_In-; TestPoint_Pad_1.0x1.0mm
TP16: 1V25; TestPoint_Pad_1.0x1.0mm
TP17: Sense+; TestPoint_Keystone_5005-5009_Compact
TP18: Out+; TestPoint_Keystone_5005-5009_Compact
U9: REF35125QDBVR; SOT-23-6

Connections:
+1V25: C39.1, C40.1, IC2.3 (REF2), IC2.7 (REF1), TP16.1, U9.6 (VREF)
+3.3V: C47.1, C48.1, C49.1, D15.1 (K), IC3.8 (VDD2), IC4.8 (V+); also elsewhere on the board
+3.3V HV: C37.1, C38.1, C42.1, C45.1, C46.1, IC2.6 (VS), IC3.1 (VDD1), U9.3 (EN), U9.4 (VIN); also elsewhere on the board
/Current Sense/Battery_GND: R39.MH1
/Current Sense/INPUT+: IC2.8 (IN+), SW3.2 (B)
/Current Sense/INPUT-: IC2.1 (IN-), SW3.5 (B)
/Current Sense/I_OUT: D15.2 (A), D16.1 (K), IC4.6 (IN2-), IC4.7 (OUT2); also elsewhere on the board
/Current Sense/OUT1: C41.2, IC4.1 (OUT1), IC4.5 (IN2+), R25.2
/Current Sense/OUT+: IC3.7 (OUTP), R26.1, TP18.1
/Current Sense/Output_GND: R39.MH2
/Current Sense/SENSE+: C43.1, IC2.5 (OUT), IC3.2 (INP), TP17.1
/Current Sense/SHUNT+: R39.2, SW3.1 (A), TP10.1
/Current Sense/SHUNT-: R39.1, SW3.4 (A), TP11.1
/Current Sense/Scrut+: J6.1, R28.1, TP12.1
/Current Sense/Scrut-: J6.2, R29.2, SW3.6 (C), TP14.1
/Current Sense/Scrut_Out: R28.2, R29.1, SW3.3 (C), TP13.1
GND: C44.2, C47.2, C48.2, C49.2, D16.2 (A), IC3.5 (GND2), IC3.6 (OUTN), IC4.3 (IN1+), IC4.4 (V-); also elsewhere on the board
GND HV: C37.2, C38.2, C39.2, C40.2, C42.2, C43.2, C45.2, C46.2, IC2.2 (GND), IC3.3 (INN), IC3.4 (GND1), U9.1 (GND), U9.2 (GND); also elsewhere on the board
unnamed: C44.1, R25.1, R26.2, R27.1
unnamed: C41.1, IC4.2 (IN1-), R27.2

Notes on the sheet:
Gain: 100 V/V (INA241 A4 version) Reference voltage (bias for discharge): 1.25V * (70A * 250 uOhm * 100)V + Vref = 3 V * (-32A * 250 uOhm * 100)V + Vref = 0.45 V Maximum current range: -46 to +78A (0.1 to 3.2V output)
-->
(0.00145) V_in
filter
unity gain buffer
Current Sensing
Fixed Gain: 0.4 V/V Target Voltage Ranges: * Input: 0.1 - 3.2 V * Output: 0.04 - 1.28 V
Bidirectional current sense amp
Current = ( (ADC * (3.3 / 4096) - Vref) / (Shunt*gain) ) Vref = 1.25 Shunt * gain = 250u * 100 V/V = 0.025
Gain: 100 V/V Rsense = 250 uOhm Psense = Rsense * (70A)^2 = 1.225 W Picked shunt first, then adjusted gain to meet ADC range If additional gain is needed, tweak filter circuit
Low-Side Shunt: * Discharge: Output_GND -> Battery_GND * Charge: Battery_GND -> Output_GND
ADC to Current Conversion
Isolation
Low-Pass Filter
250 uOhm
Scrutineering: - Pass in voltage from scrutineering board - Use switch to select between shunt / scrutineering inputs Expected Voltage Input: +- 12V Scrutineering Output: +- 18 mV
Shunt -> current sense -> isolation -> filter
Current Scrutineering
Voltage Reference (1.25V)
250uOhm Shunt Resistor
bypass
caps from precision reference example in datasheet
Expected current range: -32A to +70A => Voltage range: -8 to 17.5 mV
2nd order lowpass Butterworth filter (see filter pdf) * Cutoff frequency: 10 Hz * Rolloff: -40dB / decade * Gain: 2.5 V/V Target Output voltage range: 0.1 - 3.2 V
Noise reducation is optional
Footprint is M4 version; edit it to have M3 holes

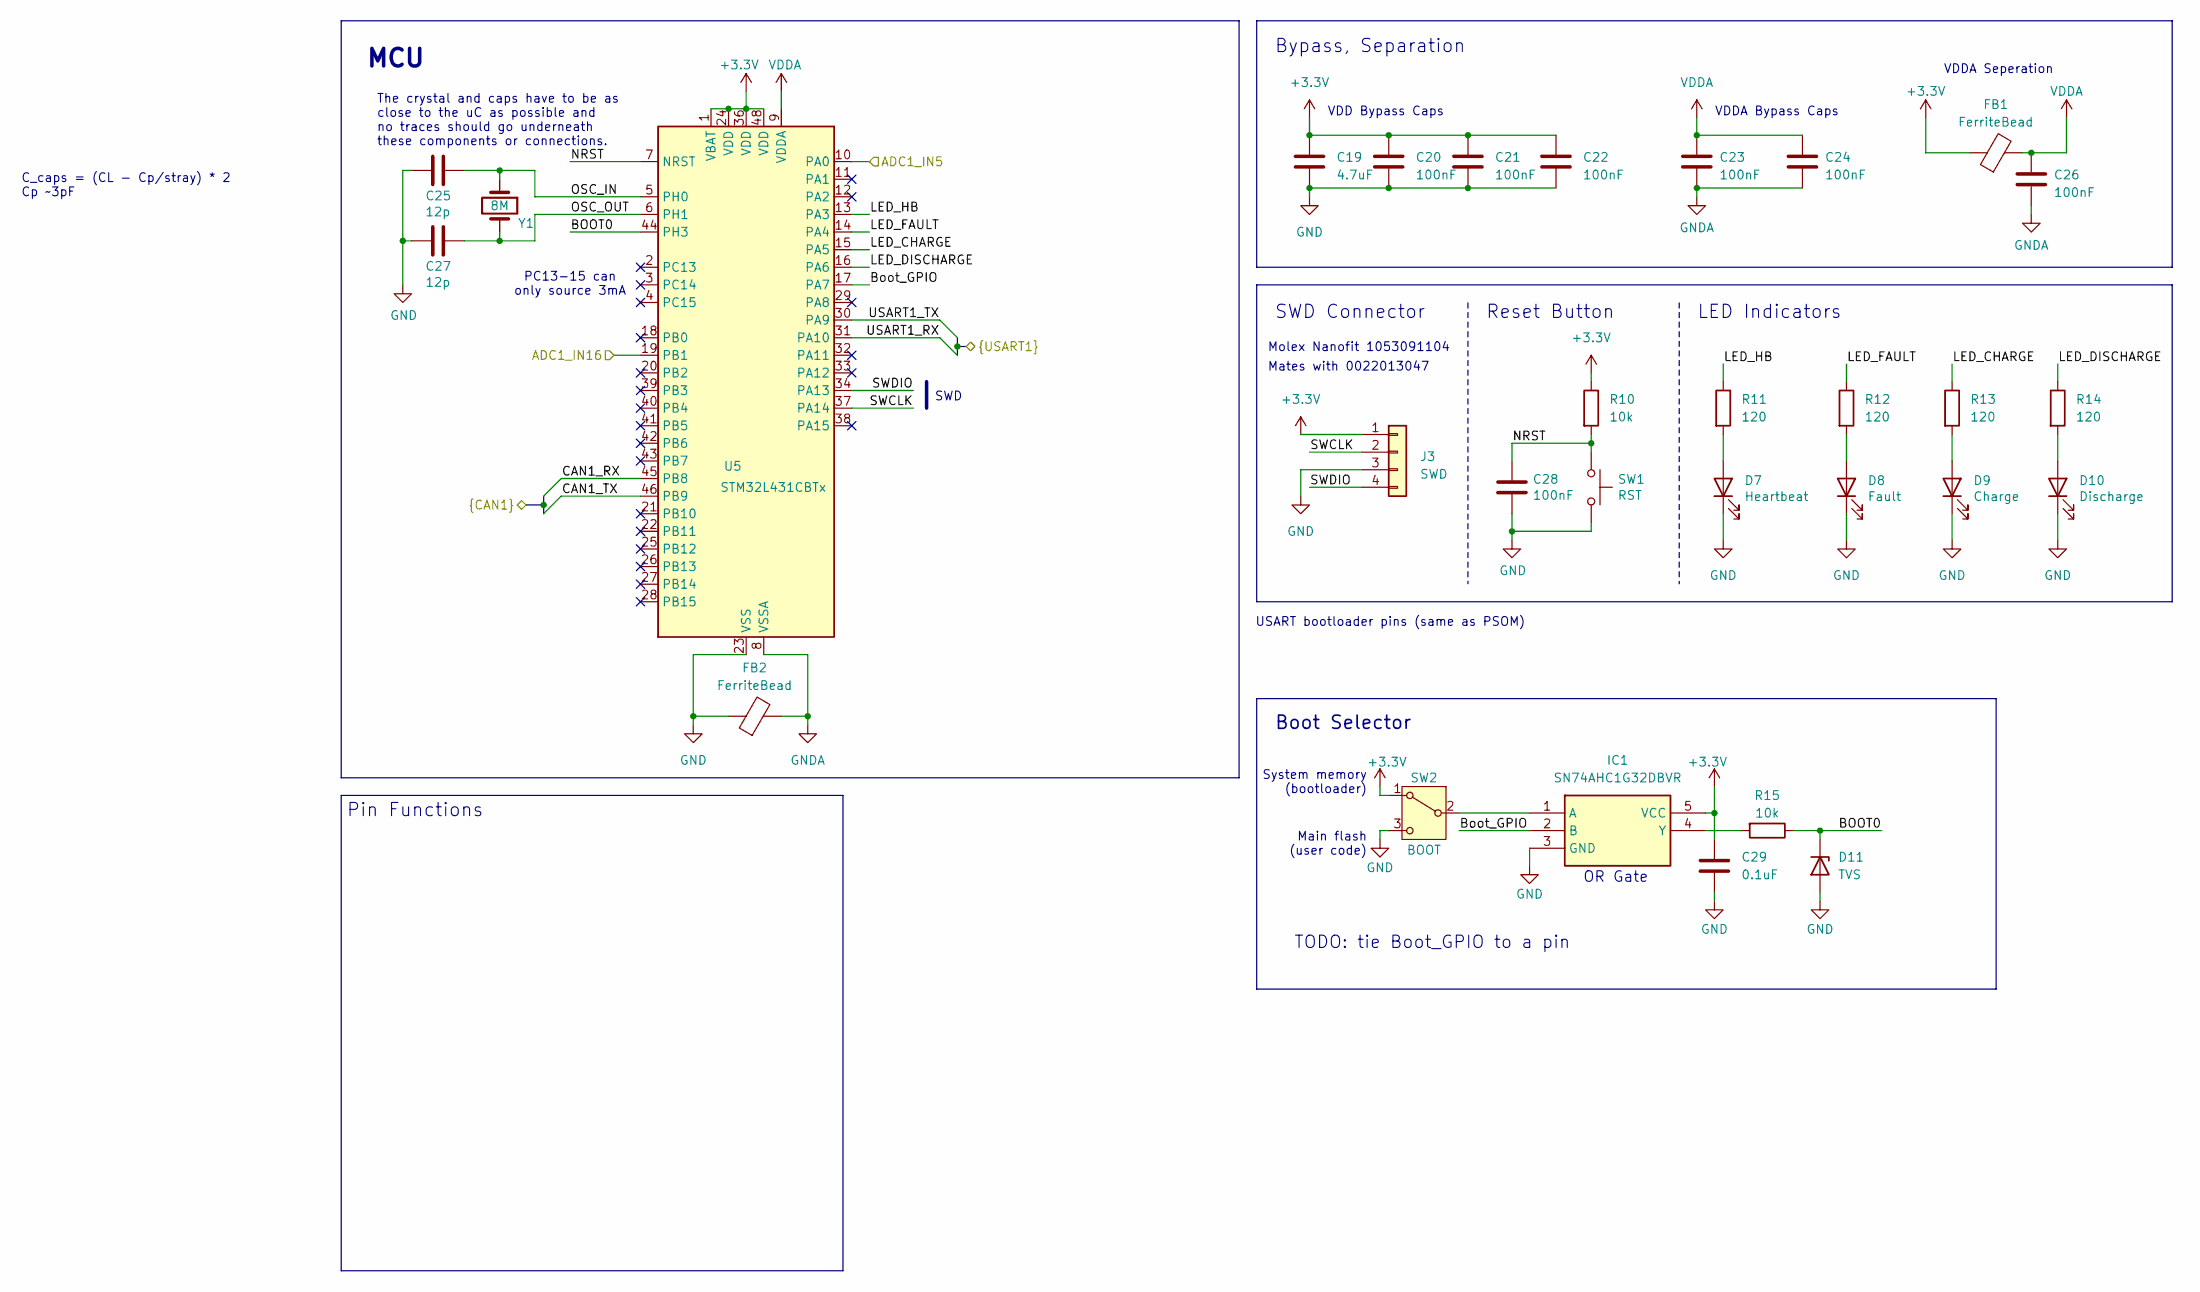
[picture p23: schematic MCU.kicad_sch]

Parts:
C19: 4.7uF; C_0805_2012Metric_Pad1.18x1.45mm_HandSolder
C20, C21, C22, C23, C24, C26, C28: 100nF; C_0603_1608Metric_Pad1.08x0.95mm_HandSolder; Mouser Part Number 80-C0805C104M5R
C25, C27: 12p; C_0603_1608Metric_Pad1.08x0.95mm_HandSolder; Mouser Part Number 80-C0805C120K5HACTU
C29: 0.1uF; C_0603_1608Metric_Pad1.08x0.95mm_HandSolder; Mouser Part Number 80-C0805C104M5R
D7: Heartbeat; LED_0603_1608Metric_Pad1.05x0.95mm_HandSolder
D8: Fault; LED_0603_1608Metric_Pad1.05x0.95mm_HandSolder
D9: Charge; LED_0603_1608Metric_Pad1.05x0.95mm_HandSolder
D10: Discharge; LED_0603_1608Metric_Pad1.05x0.95mm_HandSolder
D11: TVS; D_SOD-123F
FB1, FB2: FerriteBead; C_0603_1608Metric_Pad1.08x0.95mm_HandSolder; Mouser Part Number 704-MFBW1V2012-121-R
IC1: SN74AHC1G32DBVR; Mouser Part Number 595-SN74AHC1G32DBVR
J3: SWD; Molex_Nano-Fit_105309-xx04_1x04_P2.50mm_Vertical
R10: 10k; R_0603_1608Metric_Pad0.98x0.95mm_HandSolder; Mouser Part Number 71-CRCW080510K0FKEAC
R11, R12, R13, R14: 120; R_0603_1608Metric_Pad0.98x0.95mm_HandSolder
R15: 10k; R_0603_1608Metric_Pad0.98x0.95mm_HandSolder
SW1: RST; SW_TL3365AF180QG
SW2: BOOT; SW_CJS-1200TA
U5: STM32L431CBTx; LQFP-48_7x7mm_P0.5mm; Mouser Part Number 511-STM32L431CBT6
Y1: 8M; Crystal_SMD_Abracon_ABM3-2Pin_5.0x3.2mm; Mouser Part Number 815-ABM3-8-D2Y-T

Connections:
+3.3V: C19.1, C20.1, C21.1, C22.1, C29.1, FB1.1, IC1.5 (VCC), J3.1, R10.1, SW2.1 (A), U5.1 (VBAT), U5.24 (VDD), U5.36 (VDD), U5.48 (VDD); also elsewhere on the board
/CAN/CAN1_RX: U5.45 (PB8); also elsewhere on the board
/CAN/CAN1_TX: U5.46 (PB9); also elsewhere on the board
/Current Sense/I_OUT: U5.10 (PA0); also elsewhere on the board
/MCU/ADC1_IN16: U5.19 (PB1); also elsewhere on the board
/MCU/BOOT0: D11.1 (K), R15.1, U5.44 (PH3)
/MCU/Boot_GPIO: IC1.2 (B), U5.17 (PA7)
/MCU/LED_CHARGE: R13.1, U5.15 (PA5)
/MCU/LED_DISCHARGE: R14.1, U5.16 (PA6)
/MCU/LED_FAULT: R12.1, U5.14 (PA4)
/MCU/LED_HB: R11.1, U5.13 (PA3)
/MCU/NRST: C28.1, R10.2, SW1.1, U5.7 (NRST)
/MCU/OSC_IN: C25.1, U5.5 (PH0), Y1.1
/MCU/OSC_OUT: C27.1, U5.6 (PH1), Y1.2
/MCU/SWCLK: J3.2, U5.37 (PA14)
/MCU/SWDIO: J3.4, U5.34 (PA13)
/MCU/USART1_RX: U5.31 (PA10); also elsewhere on the board
/MCU/USART1_TX: U5.30 (PA9); also elsewhere on the board
GND: C19.2, C20.2, C21.2, C22.2, C25.2, C27.2, C28.2, C29.2, D7.1 (K), D8.1 (K), D9.1 (K), D10.1 (K), D11.2 (A), FB2.1, IC1.3 (GND), J3.3, SW1.2, SW2.3 (C), U5.23 (VSS), U5.35 (VSS), U5.47 (VSS); also elsewhere on the board
GNDA: C23.2, C24.2, C26.2, FB2.2, U5.8 (VSSA)
unnamed: D7.2 (A), R11.2
unnamed: D8.2 (A), R12.2
unnamed: D9.2 (A), R13.2
unnamed: D10.2 (A), R14.2
unnamed: IC1.1 (A), SW2.2 (B)
unnamed: IC1.4 (Y), R15.2
VDDA: C23.1, C24.1, C26.1, FB1.2, U5.9 (VDDA)

Notes on the sheet:
SWD
Pin Functions
LED Indicators
Molex Nanofit 1053091104
PC13-15 can only source 3mA
MCU
Mates with 0022013047
The crystal and caps have to be as close to the uC as possible and no traces should go underneath these components or connections.
SWD Connector
C_caps = (CL - Cp/stray) * 2 Cp ~3pF
System memory (bootloader)
Reset Button
Boot Selector
USART bootloader pins (same as PSOM)
VDDA Bypass Caps
TODO: tie Boot_GPIO to a pin
VDD Bypass Caps
VDDA Seperation
OR Gate
Bypass, Separation
Main flash (user code)

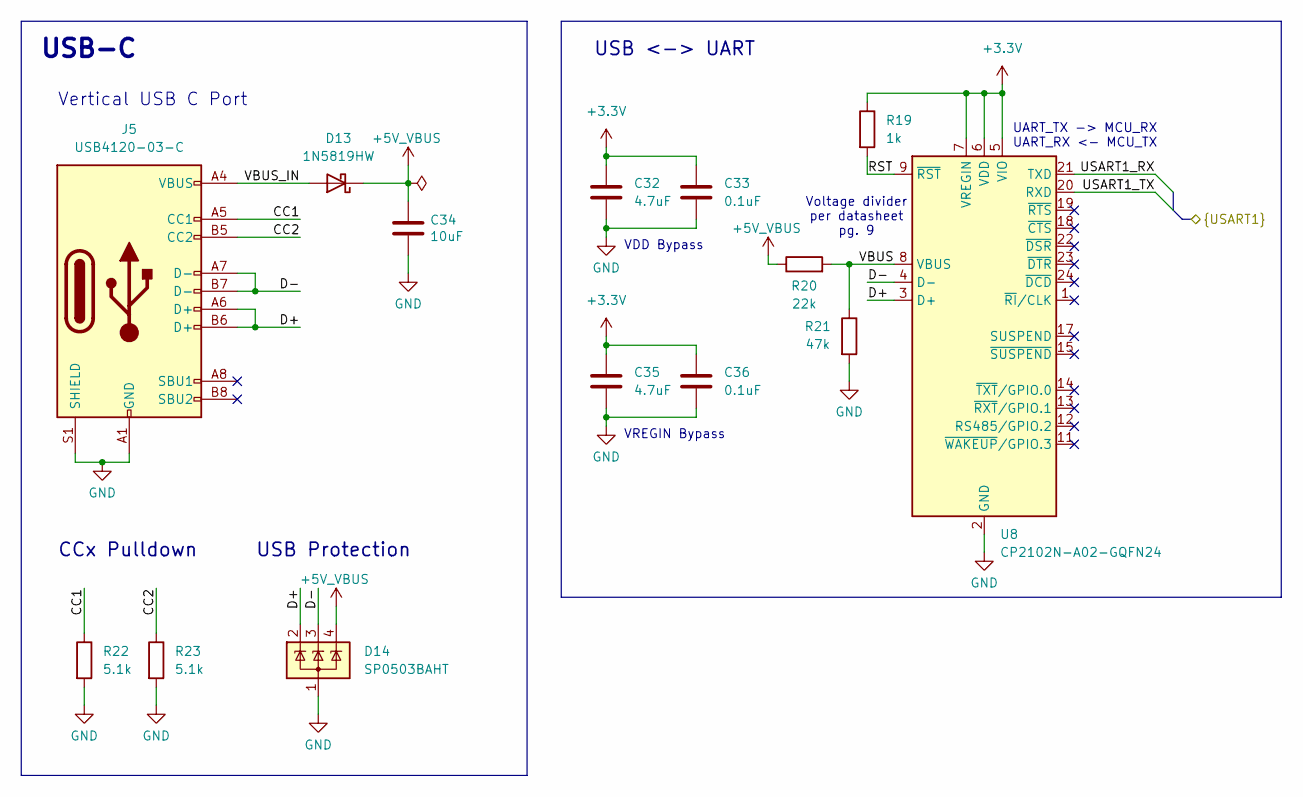
[picture p24: schematic USB.kicad_sch]

Parts:
C32, C35: 4.7uF; C_0805_2012Metric_Pad1.18x1.45mm_HandSolder
C33, C36: 0.1uF; C_0603_1608Metric_Pad1.08x0.95mm_HandSolder
C34: 10uF; C_0805_2012Metric_Pad1.18x1.45mm_HandSolder
D13: 1N5819HW; D_SOD-123
D14: SP0503BAHT; SOT-143; Mouser Part Number 576-SP0503BAHTG
J5: USB4120-03-C; USB412003C
R19: 1k; R_0603_1608Metric_Pad0.98x0.95mm_HandSolder
R20: 22k; R_0603_1608Metric_Pad0.98x0.95mm_HandSolder
R21: 47k; R_0603_1608Metric_Pad0.98x0.95mm_HandSolder
R22, R23: 5.1k; R_0603_1608Metric_Pad0.98x0.95mm_HandSolder
U8: CP2102N-A02-GQFN24

Connections:
+3.3V: C32.1, C33.1, C35.1, C36.1, R19.1, U8.5 (VIO), U8.6 (VDD), U8.7 (VREGIN); also elsewhere on the board
+5V_VBUS: C34.1, D13.1 (K), D14.4 (K), R20.1; also elsewhere on the board
/MCU/USART1_RX: U8.21 (TXD); also elsewhere on the board
/MCU/USART1_TX: U8.20 (RXD); also elsewhere on the board
/USB/CC1: J5.A5 (CC1), R22.1
/USB/CC2: J5.B5 (CC2), R23.1
/USB/D+: D14.2 (K), J5.A6 (D+), J5.B6 (D+), U8.3 (D+)
/USB/D-: D14.3 (K), J5.A7 (D-), J5.B7 (D-), U8.4 (D-)
/USB/RST: R19.2, U8.9 (~RST)
/USB/VBUS: R20.2, R21.1, U8.8 (VBUS)
/USB/VBUS_IN: D13.2 (A), J5.A4 (VBUS), J5.A9 (VBUS), J5.B4 (VBUS), J5.B9 (VBUS)
GND: C32.2, C33.2, C34.2, C35.2, C36.2, D14.1 (A), J5.A1 (GND), J5.A12 (GND), J5.B1 (GND), J5.B12 (GND), J5.S1 (SHIELD), R21.2, R22.2, R23.2, U8.2 (GND), U8.25 (GND); also elsewhere on the board

Notes on the sheet:
USB-C
USB <-> UART
Voltage divider per datasheet pg. 9
Vertical USB C Port
VDD Bypass
CCx Pulldown
UART_TX -> MCU_RX UART_RX <- MCU_TX
VREGIN Bypass
USB Protection

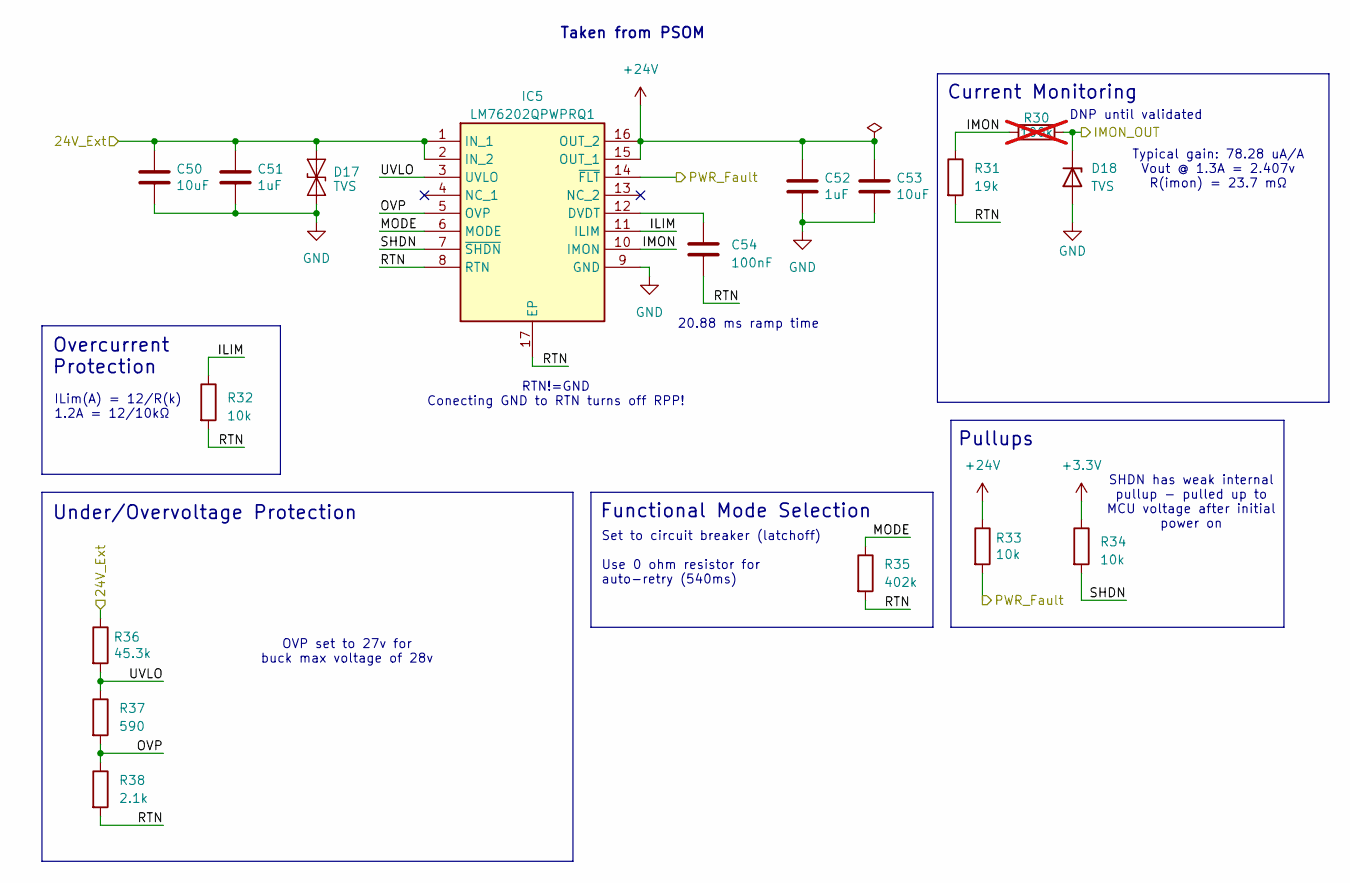
[picture p25: schematic PowerProtection.kicad_sch]

Parts:
C50, C53: 10uF; C_0805_2012Metric_Pad1.18x1.45mm_HandSolder
C51, C52: 1uF; C_0603_1608Metric_Pad1.08x0.95mm_HandSolder
C54: 100nF; C_0603_1608Metric_Pad1.08x0.95mm_HandSolder
D17: TVS; D_SOD-323_HandSoldering
D18: TVS; D_SOD-123F
IC5: LM76202QPWPRQ1; Mouser Part Number 595-LM76202QPWPRQ1
R30: 100k; R_0603_1608Metric_Pad0.98x0.95mm_HandSolder; not fitted
R31: 19k; R_0603_1608Metric_Pad0.98x0.95mm_HandSolder
R32, R33, R34: 10k; R_0603_1608Metric_Pad0.98x0.95mm_HandSolder
R35: 402k; R_0603_1608Metric_Pad0.98x0.95mm_HandSolder
R36: 45.3k; R_0603_1608Metric_Pad0.98x0.95mm_HandSolder
R37: 590; R_0603_1608Metric_Pad0.98x0.95mm_HandSolder
R38: 2.1k; R_0603_1608Metric_Pad0.98x0.95mm_HandSolder

Connections:
+3.3V: R34.1; also elsewhere on the board
+24V: C52.1, C53.1, IC5.15 (OUT_1), IC5.16 (OUT_2), R33.1; also elsewhere on the board
+24V_Ext: C50.1, C51.1, D17.2 (A2), IC5.1 (IN_1), IC5.2 (IN_2), R36.1; also elsewhere on the board
/MCU/ADC1_IN16: D18.1 (K), R30.2; also elsewhere on the board
/Power/PWR_Fault: IC5.14 (~FLT), R33.2; also elsewhere on the board
/Power/PowerProtection/ILIM: IC5.11 (ILIM), R32.1
/Power/PowerProtection/IMON: IC5.10 (IMON), R30.1, R31.1
/Power/PowerProtection/MODE: IC5.6 (MODE), R35.1
/Power/PowerProtection/OVP: IC5.5 (OVP), R37.2, R38.1
/Power/PowerProtection/RTN: C54.2, IC5.8 (RTN), IC5.17 (EP), R31.2, R32.2, R35.2, R38.2
/Power/PowerProtection/SHDN: IC5.7 (~SHDN), R34.2
/Power/PowerProtection/UVLO: IC5.3 (UVLO), R36.2, R37.1
GND: C50.2, C51.2, C52.2, C53.2, D17.1 (A1), D18.2 (A), IC5.9 (GND); also elsewhere on the board
unnamed: C54.1, IC5.12 (DVDT)

Notes on the sheet:
OVP set to 27v for buck max voltage of 28v
DNP until validated
RTN!=GND Conecting GND to RTN turns off RPP!
Under/Overvoltage Protection
Typical gain: 78.28 uA/A Vout @ 1.3A = 2.407v R(imon) = 23.7 mΩ
ILim(A) = 12/R(k) 1.2A = 12/10kΩ
SHDN has weak internal pullup - pulled up to MCU voltage after initial power on
20.88 ms ramp time
Set to circuit breaker (latchoff) Use 0 ohm resistor for auto-retry (540ms)
Pullups
Overcurrent Protection
Functional Mode Selection
Current Monitoring
Taken from PSOM
