lhr-solar/PS-Amperes/Hardware/PS-AmperesPCB.kicad_pcb

## KiCad design Hardware/PS-AmperesPCB.kicad_pcb (continued)

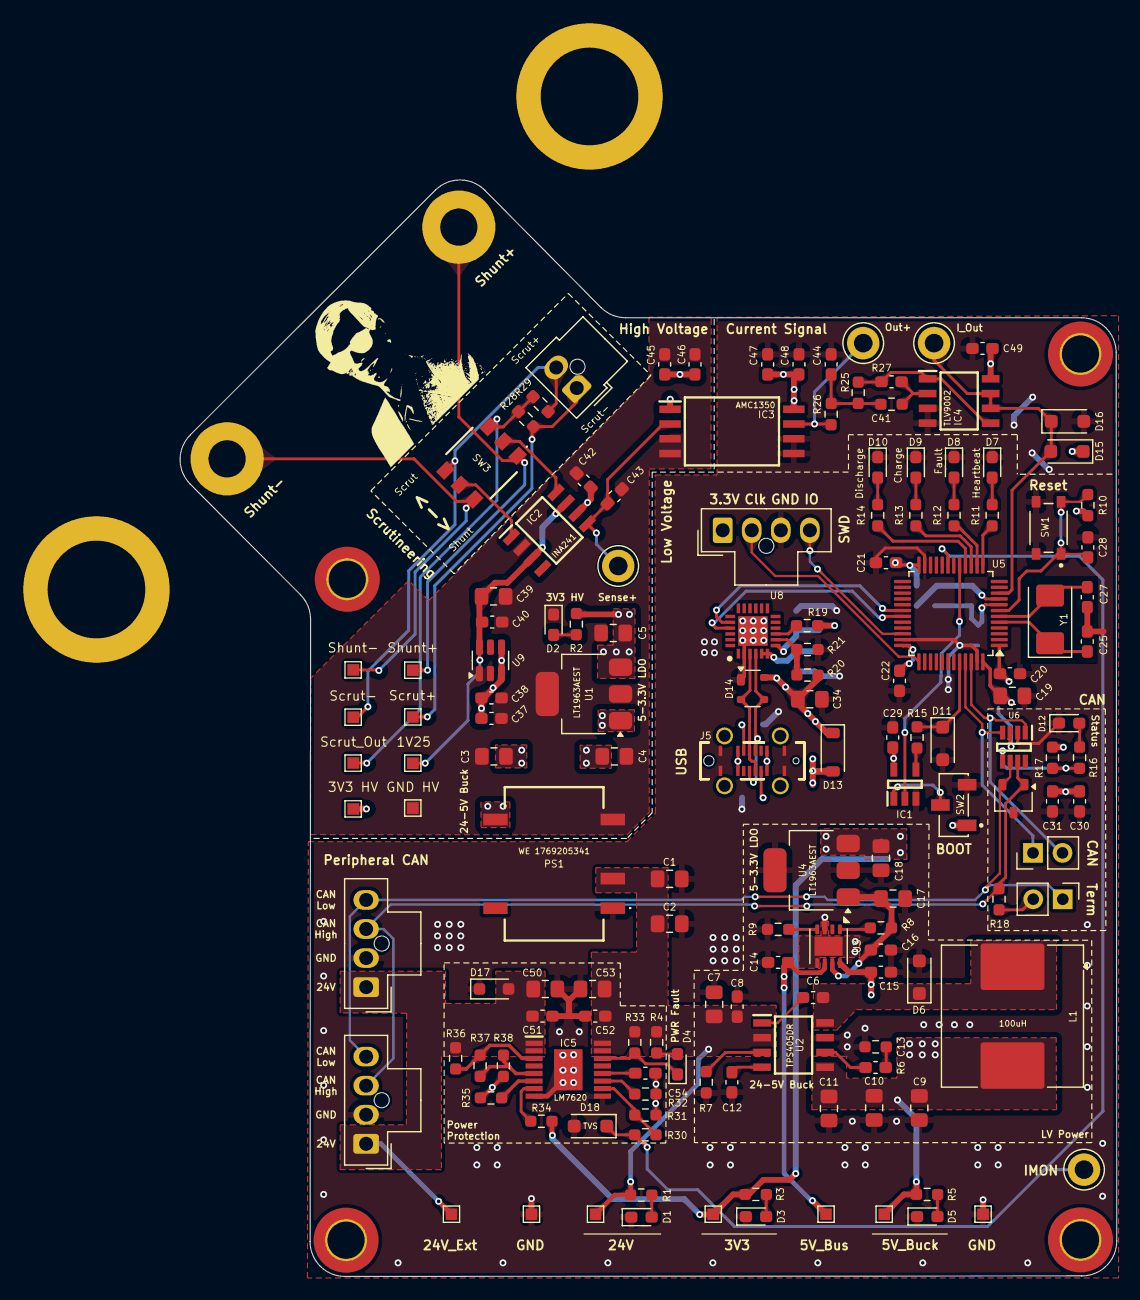
[picture p26: board PS-AmperesPCB.kicad_pcb from above]

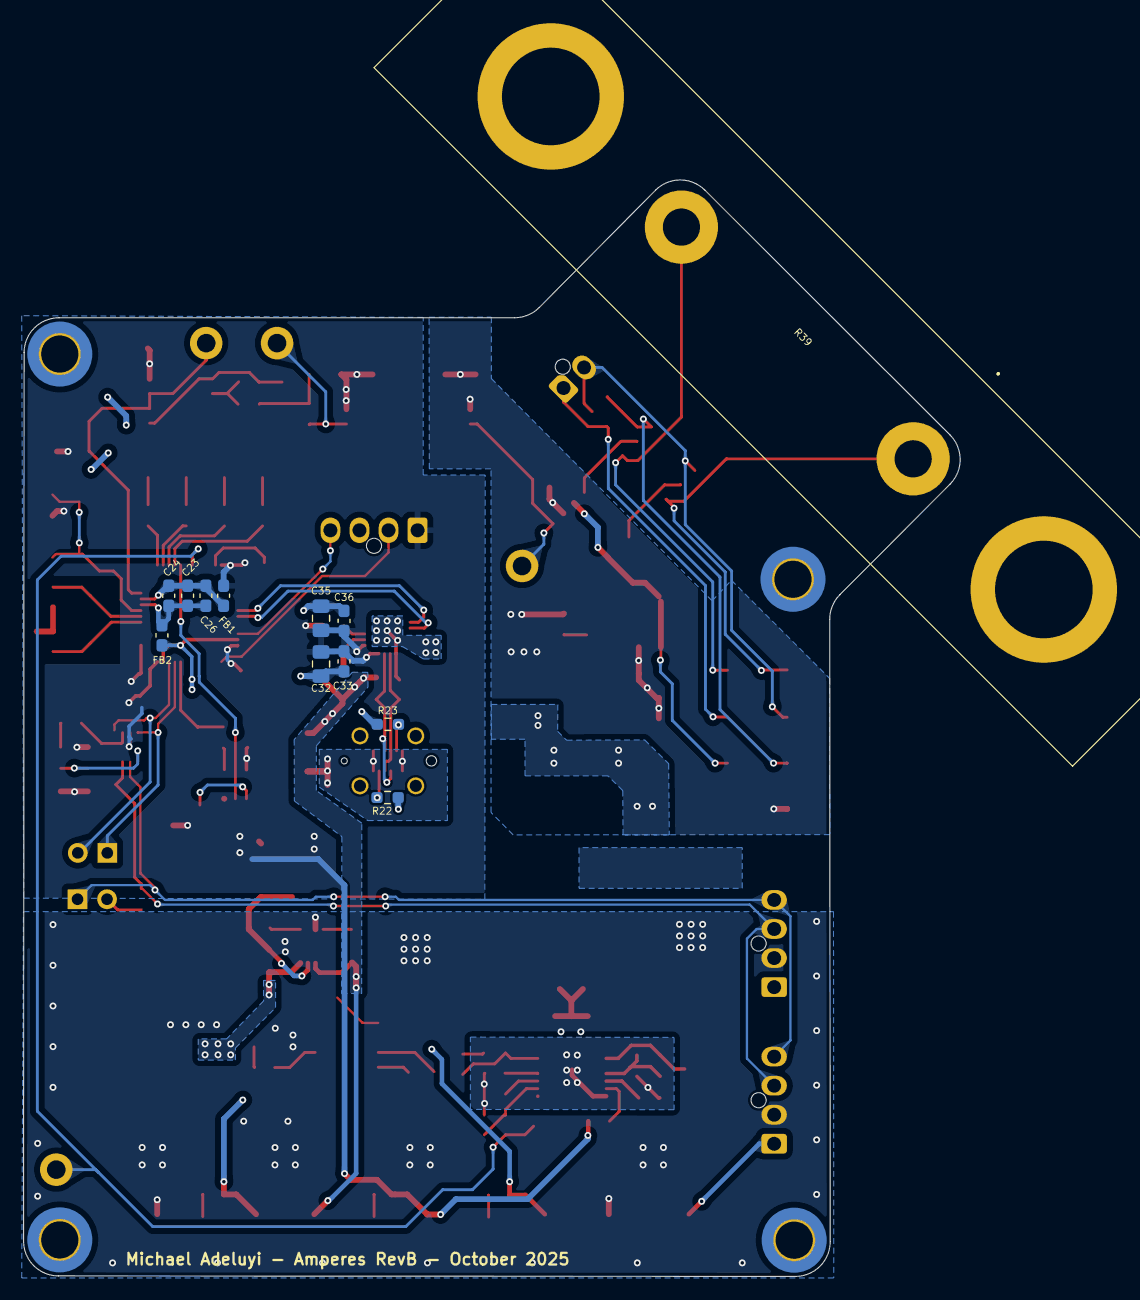
[picture p27: board PS-AmperesPCB.kicad_pcb from below]

Board: 2 copper layers, 80.6 x 94.4 mm, 164 parts (13 on the bottom side), 82 nets.
