lhr-solar/PS-Amperes/BPS-Amperes.ioc

Mcu.UserName=STM32L431CBTx
PA0.Signal=ADCx_IN5
PA10.Signal=USART1_RX
PA3.Signal=GPIO_Output
PA4.Signal=GPIO_Output
PA5.Signal=GPIO_Output
PA6.Signal=GPIO_Output
PA7.Signal=GPIO_Output
PA9.Signal=USART1_TX
PB8.Signal=CAN1_RX
PB9.Signal=CAN1_TX
