lhr-solar/PS-Amperes/(commit log)

2025-02-01 layout draft
    [BPS-AmperesPCB.kicad_sch]
2025-02-01 new footprints
2025-02-01 working layout
    [BPS-AmperesPCB.kicad_pcb]
2025-02-01 tag team
    [BPS-AmperesPCB.kicad_pcb, BPS-AmperesPCB.kicad_sch]
2025-02-01 changed layout
    [BPS-AmperesPCB.kicad_pcb]
2025-02-08 reviewable part 2
    [BPS-AmperesPCB.kicad_pcb]
2025-02-08 decor fancy
    [BPS-AmperesPCB.kicad_pcb, BPS-AmperesPCB.kicad_sch]
2025-02-11 bored so i did lhr
    [BPS-AmperesPCB.kicad_pcb, BPS-AmperesPCB.kicad_sch]
2025-02-15 fixed outp and outn flip smh
    [BPS-AmperesPCB.kicad_pcb, BPS-AmperesPCB.kicad_sch]
2025-02-15 edits 1.0 still have to change some stuff Lakshay
    [BPS-AmperesPCB.kicad_pcb]
2025-02-17 gerb'd all over da place
    [BPS-AmperesPCB.kicad_pcb, BPS-AmperesPCB.kicad_sch, PowerDist.kicad_sch, ina226.kicad_sch, ina293.kicad_sch]
2025-04-12 Amperes v1.0 (#1)
    * new parts
    * Testpoints and Math
    * Daisy Chain CAN Connectors
    * layout draft
    * new footprints
    * working layout
    * tag team
    * ignore working files
    * changed layout
    * reviewable
    * reviewable part 2
    * decor fancy
    * tada
    * bored so i did lhr
    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
    [BPS-AmperesPCB.kicad_pcb, BPS-AmperesPCB.kicad_sch, PowerDist.kicad_sch, ina226.kicad_sch, ina293.kicad_sch]
2025-11-04 RevB (#2)
    * initial sch change, added PSOM components
    * migrated to KiCad 9
    * replaced UTSVT with KiCAD-Bild submodule
    * updated symbol, footprint paths
    * mcu and CAN added, missing Amperes DC-DC sym / footprint
    * added RO-123.3S_HP part but it might not be the right one
    * addressed comments
    * isolated 3v3 done?
    * finished? power on sch
    * added MX cube pinout screenshot
    * power
    * added 24V buck, bypass caps, more LEDs; started scrutineering circuit and bidirectional current sense
    * organization, updated submodule
    * small tweaks
    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
    [AMC1350DWVR.stp, BOM-PS-AmperesPCB.csv, BPS-AmperesPCB.kicad_pcb, BPS-AmperesPCB.kicad_sch, CAN.kicad_sch, Current_Sense.kicad_sch, INA241A5IDR.stp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]
